calvin-college-team-pica/final-design-report/README.md

# final-design-report
Final Design Report for Senior Design project
