calvin-college-team-pica/final-design-report/tables/EMeter_Pinout.tex

{
\begin{longtable}[c]{|l|c|r|}
\caption{MSP430F47197 Pinout}\\
\hline
\rowcolor{lightgray}
  Pin Number & Pin Name & Pin Function\\ \hline\hline
\endfirsthead

\caption[]{Continued from previous page}\\
\hline
\rowcolor{lightgray}
  Pin Number & Pin Name & Pin Function\\ \hline\hline
\endhead

\multicolumn{3}{r}{{Continued on next page}} \\
\endfoot

\endlastfoot

  1 & A0+ & Phase 1 Voltage (Positive) \\
  2 & A0- & Phase 1 Voltage (Negative) \\
  3 & A1+ & Phase 2 Voltage (Positive) \\
  4 & A1- & Phase 2 Voltage (Negative) \\
  5 & A2+ & Phase 3 Voltage (Positive) \\
  6 & A2- & Phase 3 Voltage (Negative) \\
  7 & AVSS & Tie to Ground (GND) \\
  8 & AVCC & $3\volt$ input \\
  9 & VREF & Virtual Ground \\
  10 & A3+ & Phase 1 Current (Positive) \\ \hline
  11 & A3- & Phase 1 Current (Negative) \\
  12 & A4+ & Phase 2 Current (Positive) \\
  13 & A4- & Phase 2 Current (Negative) \\
  14 & A5+ & Phase 3 Current (Positive) \\
  15 & A5- & Phase 3 Current (Negative) \\
  16 & A6+ & Unused \\
  17 & A6- & Unused \\
  18 & VSS & Tie to Ground (GND) \\
  19 & S0 & LCD segment pin 00 \\
  20 & S1 & LCD segment pin 01 \\ \hline
  21 & S2 & LCD segment pin 02 \\
  22 & S3 & LCD segment pin 03 \\
  23 & S4 & LCD segment pin 04 \\
  24 & S5 & LCD segment pin 05 \\
  25 & S6 & LCD segment pin 06 \\
  26 & S7 & LCD segment pin 07 \\
  27 & S8 & LCD segment pin 08 \\
  28 & S9 & LCD segment pin 09 \\
  29 & S10 & LCD segment pin 10 \\
  30 & S11 & LCD segment pin 11 \\ \hline
  31 & S12 & LCD segment pin 12 \\
  32 & S13 & LCD segment pin 13 \\
  33 & S14 & LCD segment pin 14 \\
  34 & S15 & LCD segment pin 15 \\
  35 & S16 & LCD segment pin 16 \\
  36 & S17 & LCD segment pin 17 \\
  37 & S18 & LCD segment pin 18 \\
  38 & S19 & LCD segment pin 19 \\
  39 & S20 & LCD segment pin 20 \\
  40 & S21 & LCD segment pin 21 \\ \hline
  41 & S22 & LCD segment pin 22 \\
  42 & S23 & LCD segment pin 23 \\
  43 & S24 & LCD segment pin 24 \\
  44 & S25 & LCD segment pin 25 \\
  45 & S26 & LCD segment pin 26 \\
  46 & S27 & LCD segment pin 27 \\
  47 & S28 & LCD segment pin 28 \\
  48 & S29 & LCD segment pin 29 \\
  49 & S30 & LCD segment pin 30 \\
  50 & S31 & LCD segment pin 31 \\
  51 & S32 & LCD segment pin 32 \\
  52 & S33 & LCD segment pin 33 \\
  53 & S34 & LCD segment pin 34 \\
  54 & S35 & LCD segment pin 35 \\
  55 & P5.0 & Unused \\
  56 & COM0 & LCD commmon 0 \\
  57 & COM1 & LCD commmon 1 \\
  58 & COM2 & LCD commmon 2 \\
  59 & COM3 & LCD commmon 3 \\
  60 & P5.5 & Unused \\
  60 & P5.5 & Unused \\
  60 & P5.5 & Unused \\
  63 & LCDCAP & Charge pump capactior ($22\micro\farad$ to ground) \\
  64 & DVCC2 & Digital voltage input ($1.5\volt$) \\
  65 & XIN & $32.768\kilo\hertz$ crystal \\
  66 & XOUT & $32.768\kilo\hertz$ crystal \\
  67 & DVSS2 & Tie to Ground (GND) \\
  68 & S36 & LCD segment pin 36 \\
  69 & S37 & LCD segment pin 37 \\
  70 & S38 & LCD segment pin 38 \\
  71 & S39 & LCD segment pin 39 \\
  72 & P3.3 & Unused \\
  73 & P3.2 & Unused \\
  74 & P3.1 & Unused \\
  75 & P3.0 & Unused \\
  76 & P2.7 & Unused \\
  77 & P2.6 & Unused \\
  78 & P2.5 & RS232 RX \\
  79 & P2.4 & RS232 TX \\
  80 & P2.3 & Button \\
  81 & P2.2 & Unused \\
  82 & P2.1 & Unused \\
  82 & P2.0 & Unused \\
  82 & P1.7 & Unused \\
  85 & P1.6 & LED3 (Green)\\
  86 & P1.5 & LED2 (Amber)\\
  85 & P1.4 & LED1 (Red) \\
  88 & P1.3 & Unused \\
  89 & P1.2 & LCD Backlight LED \\
  90 & P1.1 & Unused \\
  91 & P1.0 & Unused \\
  92 & DVCC & $100\nano\farad$ capacitor \\
  93 & XT2OUT & $16.000\mega\hertz$ crystal \\
  94 & XT2IN & $16.000\mega\hertz$ crystal \\
  95 & DVSS1 & Tie to Ground (GND) \\
  96 & TDO/TDI & JTAG Test Data Out/In \\
  97 & TDI/TCLK & JTAG Test Data Out / Test Clock \\
  98 & TMS & Test Mode Select \\
  99 & TCK & Test Clock \\
  100 & RST & Reset (Assert Hi) \\ \hline
\end{longtable}
}
