calvin-college-team-pica/final-design-report/acronyms.tex

%\begin{table}[htdp]
%\caption{default}
\section{Acronyms}
\begin{acronym}[TDMA]
\acro{AC}{Alternating Current}
\acro{AD}{Analog Devices}
\acro{ADC}{Analog-to-Digital Converter}
\acro{AES}{Advanced Encryption Standard}
\acro{AMR}{Automated Meter Reading}
\acro{ANSI}{American National Standards Institute}
\acro{CAD}{Computer Aided Design}
\acro{CCS4}{Code Composer Studio 4}
\acro{CDMA}{Code Devision Multiple Access}
\acro{CF}{Compact Flash}
\acro{CPLD}{Complex Programmable Logic Device}
\acro{DC}{Direct Current}
\acro{DHCP}{Dynamic Host Configuration Protocol}
\acro{DIP}{Dual Inline Package}
\acro{DMM}{Digital Multi-Meter}
\acro{DOE}{United States Department of Energy}
\acro{DSR}{Data Set Ready}
\acro{DTR}{Data Transmit Ready}
\acro{EEPROM}{Electronically Erasable Programable Read Only Memory}
\acro{ESP}{Electronic Signal Processing}
\acro{EM}{electromagnetic}
\acro{FCC}{Federal Communications Commission}
\acro{FET}{Field-Effect Transistors}
\acro{FPGA}{Field Programable Gate Array}
\acro{FPU}{Floating Point Unit}
\acro{GCC}{\acs{GNU} Compiler Collection}
\acro{GNU}{GNU's not Unix}
\acro{GPL}{GNU General Public License}
\acro{HTTP}{Hypertext Transfer Protocol}
\acro{IC}{Integrated Circuit}
\acro{IEC}{International Electrotechnical Commision}
\acro{IEEE}{International Electrical and Electronics Engineers}
\acro{ISR}{Interrupt Service Routine}
\acro{JCI}{Johnson Controls, Inc.}
\acro{JTAG}{Joint Test Area Group}
\acro{LAN}{Local Area Network}
\acro{LCD}{Liquid Crystal Display}
\acro{LED}{Light Emitting Diode}
\acro{MCU}{Master Control Unit}
\acro{MSRP}{Manufacturer Suggested Retail Price}
\acro{NEMA}{National Electrical Manufacturers Association}
\acro{NIC}{Network Interface Card}
\acro{NILM}{Non-intrusive Load Monitoring}
\acro{NPC}{National Power Corporation}
\acro{NTP}{Network Time Protocol}
\acro{OS}{Operating System}
\acro{PICA}{Power Information Collection Architecture}
\acro{PC}{Personal Computer}
\acro{PCB}{Printed Circuit Board}
\acro{PPFS}{Project Proposal and Feasibility Study}
\acro{RAM}{Random-Access Memory}
\acro{RFID}{Radio Frequency Identification Device}
\acro{RMS}{Root Mean Square}
\acro{RS232}{Recommended Standard 232}
\acro{SD}{Secure Digital}
\acro{SI}{International System of Units}
\acro{SoC}{System on a Chip}
\acro{SPI}{Serial Peripheral Bus}
\acro{TI}{Texas Instruments}
\acro{TRST}{Test Reset}
\acro{UART}{Universal Asynchronous Receiver/Transmitter}
\acro{UL}{Underwriters Laboratories}
\acro{USB}{Universal Serial Bus}
\acro{VHDL}{\ac{VHSIC} Hardware Description Language}
\acro{VHSIC}{Very High Speed Integrated Circuit}
\end{acronym}
%\label{default}
%\end{table}%
