calvin-college-team-pica/final-design-report/bootstrap.tex

\documentclass[11pt,letterpaper]{article}

\usepackage[load-configurations=version-1]{siunitx}
\usepackage{graphicx}
\usepackage{longtable}
\usepackage{outlines}

\usepackage[margin=1in]{geometry}

\usepackage{hyperref}
\usepackage{hypcap}

\newcommand{\inch}{mathrm{in}}

\begin{document}
%  \include{individualMonitor}
\include{PowerSupply}
\end{document}
