calvin-college-team-pica/final-design-report/breaker_appendix.tex

%appendix something-or-other
%code for the arduino uno

\section{Smart Breaker Appendix}
\label{sec:breaker_appendix1}

\arduinocode{code/SPI_revI}{Software Code for Arduino Uno}
