calvin-college-team-pica/final-design-report/Business_Case.tex

\section{Business Case}
\input{business/industry_profile}
\input{business/business_strategy}
\input{business/competitor_analysis}
\input{ten_year_forecast}
