calvin-college-team-pica/final-design-report/PowerSupply_appendix.tex

\section{Power Supply Photographs}
%\addtocontents{toc}{\thispagestyle{fancyplain}}
\begin{figure}[htbp]
\begin{center}
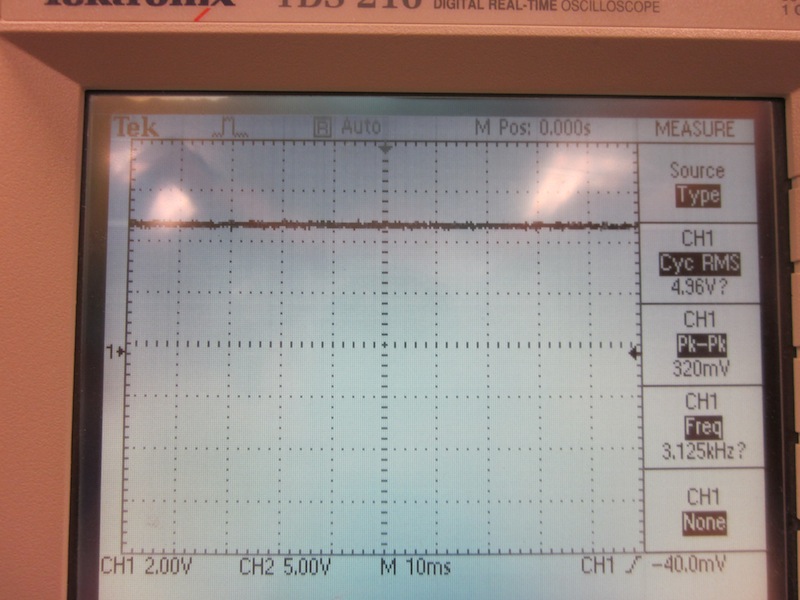
[picture p55: includes/IMG_0181.JPG]

\caption{Oscilloscope Reading-Shows about $4.96\volt$}
\end{center}
\end{figure}

\begin{figure}[htbp]
\begin{center}
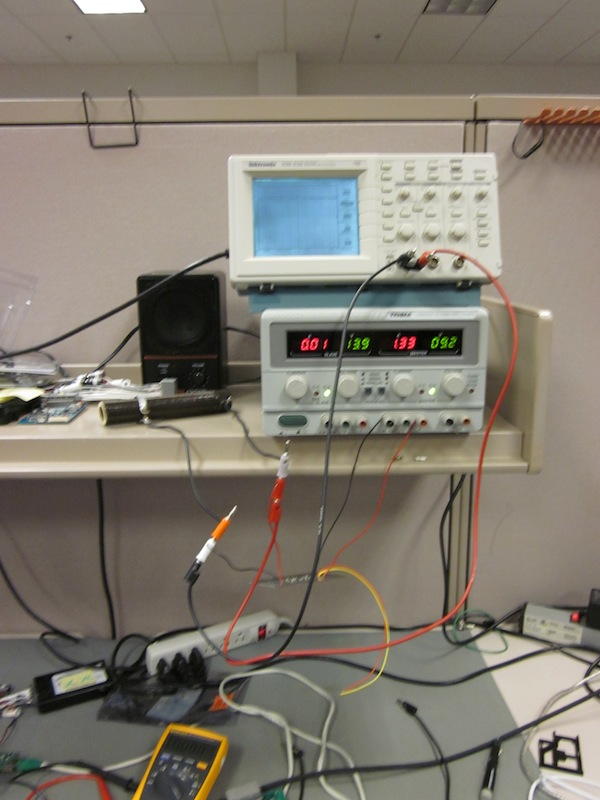
[picture p56: includes/IMG_0182.JPG]

\caption{General Test Setup}
\end{center}
\end{figure}

\begin{figure}[htbp]
\begin{center}
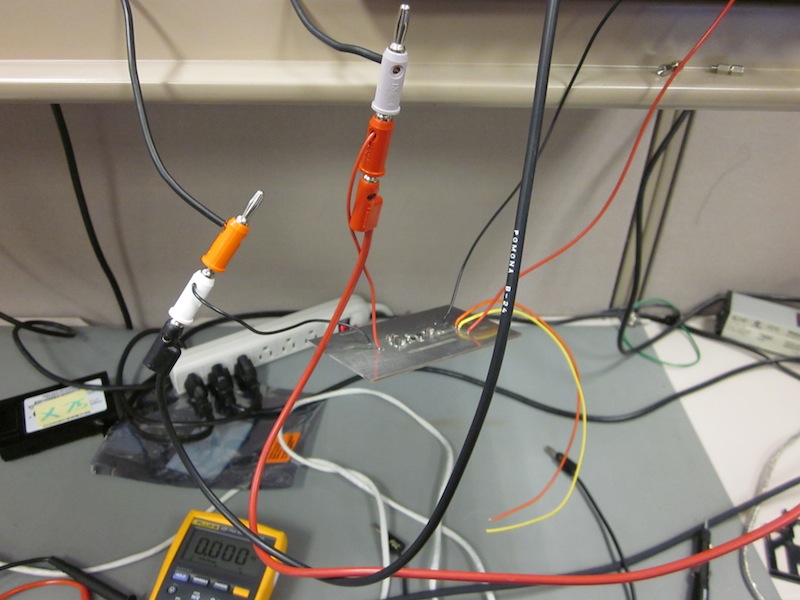
[picture p57: includes/IMG_0183.JPG]

\caption{Power Supply Being Tested}
\end{center}
\end{figure}

\begin{figure}[htbp]
\begin{center}
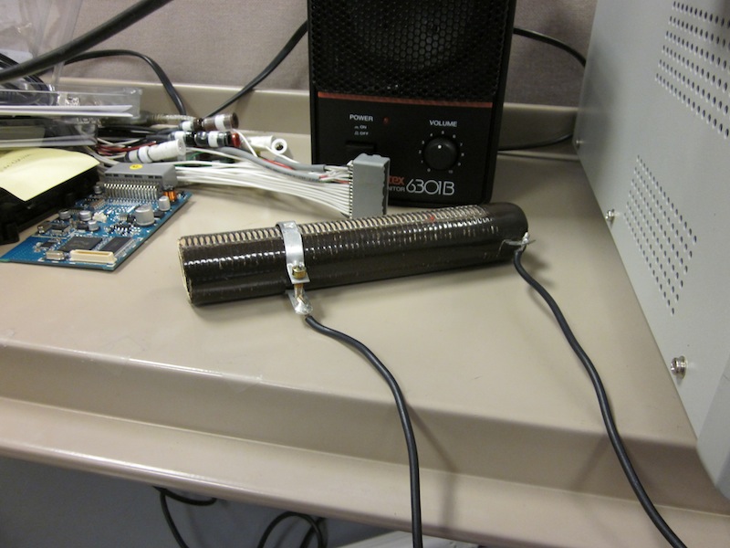
[picture p58: includes/IMG_0184.JPG]

\caption{$2.5\ohm$ Load}
\end{center}
\end{figure}
