calvin-college-team-pica/final-design-report/project_finances.tex

% \section{Project Finances}

% \subsection{Board Cost} 
% \begin{figure}[htbp]
%   \centering
%   \includegraphics[height=7in]{business/b_includes/Power_Supply_board_and_key}
%   \caption{Power supply board mockup, 92.5 x 95 mm.}
%   \label{fig:power_supply_board_mockup}
% \end{figure}
% \begin{figure}[htbp]
%   \centering
%   \subfloat[]{\label{fig:sb_board}\includegraphics[width=3in]{business/b_includes/smart_breaker_board}}\\
%   \subfloat[]{\label{fig:sb_key}\includegraphics[width=2in]{business/b_includes/smart_breaker_key}}
%   \caption{Smart breaker board mockup 72mm x 58.4mm.}
%   \label{fig:smart_breaker_board_mockup}
% \end{figure}
% \begin{figure}[htbp]
%   \centering
%   \subfloat[]{\includegraphics[height=6in]{business/b_includes/e_meter_board}}\\
%   \subfloat[]{\includegraphics[width=1in]{business/b_includes/e_meter_key}}
%   \caption{E-Meter board mockup 90mm x 47mm.}
%   \label{fig:e_meter_board_mockup}
% \end{figure}
