calvin-college-team-pica/final-design-report/business/b_tables/Power_Supply_Batch.tex

{
\begin{longtable}[c]{|>{\centering}b{1in}|c|c|c|>{\centering}b{1in}|c|}
\caption{Materials and Cost for 1000 Power Supplies\label{Power_Supply_Batch.tex}}\\
\hline
\rowcolor{blue}
Part & Quantity & Price per 1000 & For 1000 Systems & Manufacturer Part \# & Vendor \\
\hline
\endfirsthead
\caption[]{Continued from previous page}\\

\hline
\rowcolor{blue}
Part & Quantity & Price per 1000 & For 1000 Systems & Manufacturer Part \# & Vendor \\
\hline
\endhead
\multicolumn{6}{r}{{Continued on next page}} \\
\endfoot

\endlastfoot
1000uF Cap            & 1  & 2.02  & 2020     & TVX1J102MCD        & Mouser  \\
\hline
10u Cap               & 3  & 0.055 & 165      & C1206C106K9PACTU   & Mouser  \\
\hline
100n Cap              & 2  & 0.007 & 14       & C1608Y5V1H104Z     & Mouser  \\
\hline
47n Cap               & 1  & 0.036 & 36       & C1608X7S2A473K     & Mouser  \\
\hline
2.2n Cap              & 1  & 0.08  & 80       & 06035C222K4Z2A     & Mouser  \\
\hline
1n Cap                & 1  & 0.006 & 6        & C1608X7R1H102M     & Mouser  \\
\hline
2A 30V Schottky Diode & 1  & 0.169 & 169      & RB060M-30TR        & Mouser  \\
\hline
4.7u Inductor         & 1  & 0.34  & 340      & SRR0604-4R7ML      & Mouser  \\
\hline
56K Resistor          & 1  & 0.37  & 370      & RG1608N-563-B-T1   & Mouser  \\
\hline
15K Resistor          & 1  & 0.072 & 72       & TNPW060315K0DEEA   & Mouser  \\
\hline
10K Resistor          & 1  & 0.472 & 472      & PAT0603E1002BST1   & Mouser  \\
\hline
1.5K Resistor         & 2  & 0.47  & 940      & TNPW06031K50BEEN   & Mouser  \\
\hline
10 Resistor           & 2  & 0.37  & 740      & TNPW060310R0BEEA   & Mouser  \\
\hline
0.1 Resistor          & 1  & 0.121 & 121      & CRL1206-FW-R100ELF & Mouser  \\
\hline
LM25011               & 1  & 2.835 & 2835     & LM25011MY/NOPB     & Digikey \\
\hline
Transformer           & 1  & 17.28 & 17280    & 166M18             & Mouser  \\
\hline
Diode                 & 4  & 0.042 & 168      & 1N4004G            & Mouser  \\
\hline
Total:                & 25 &       & 25828.00 &                    &         \\
\hline
\hline
\end{longtable}
}
