calvin-college-team-pica/final-design-report/includes/Simplified_MSP430.pdf

Sensors | Microcontroller

LCD Display

Data Link

Debug Interface
