calvin-college-team-pica/final-design-report/business/b_includes/Power_Supply_Correct_Dims.pdf

Transformer

1000pF Cap

Diode for Bridge

LM25011

SMD Cap

Resistor

Diode
Inductor
