calvin-college-team-pica/final-design-report/includes/board_size/Breakers_Board_Est.pdf

Switch

SSR
Resistor

Opto Isolator
LED
Current
Transformer
ADE7763

Crystal

## Total=72mm X 58.4mm
