calvin-college-team-pica/final-design-report/includes/board_size/EMeter_Board_Est.pdf

Switch

Inductor
Resistor

Varistor
LED

MSP430

Diode

Crystal

Capacitor
Xbee
Max233
BJT

## Total= 90mm X 47mm

MOSFET
LCD
Display
