calvin-college-team-pica/final-design-report/includes/board_size/Power_Supply_Board_Est.pdf

Transformer

1000pF Cap

Diode for Bridge

LM25011

SMD Cap

Resistor

Diode
Inductor

# Total 95mm X 65mm
