calvin-college-team-pica/final-design-report/Final_Design_Report.tex

\documentclass[11pt,letterpaper,titlepage]{article}
% Change "article" to "report" to get rid of page number on title page
\usepackage{amsmath,amsfonts,amsthm,amssymb}
\usepackage[margin=1in]{geometry}
\usepackage{setspace}
\usepackage[T1]{fontenc}                                 %Provides T1 Font encoding for European characters
\usepackage{Tabbing}
\usepackage{array}                                       % Allows for making new column types
\usepackage{dcolumn}					 % Provides decimal alignment column macros
\usepackage{fancyhdr}                                    % Produce a "fancy" header using \rhead,\chead,\lhead
\usepackage{lastpage}
\usepackage{extramarks}
\usepackage{chngpage}
\usepackage{chngcntr} 				         % figure and equation numbering by section
\usepackage{soul}
\usepackage{bookmark}                                    % Prevents having to re-run due to labels
\usepackage[usenames,dvipsnames]{color}
\usepackage{graphicx,float,wrapfig}
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
   % passage

   \noindent\fbox{\begin{minipage}[c]{\columnwidth}#1\end{minipage}}%
   \enterProblemHeader{\homeworkProblemName}\exitProblemHeader{\homeworkProblemName}%
   \marginpar{\fbox{\homeworkSectionName}}%

   % We put the blank space above in order to make sure this
   % \marginpar gets correctly placed.
}%
   
\newcounter{subsubsubsection}[subsubsection]
\def\subsubsubsectionmark#1{}
\def\thesubsubsubsection {\thesubsubsection
     .\arabic{subsubsubsection}}
\def\subsubsubsection{\@startsection
     {subsubsubsection}{4}{\z@} {-3.25ex plus -1
     ex minus -.2ex}{1.5ex plus .2ex}{\normalsize\sf}}
% mj02r: original:
%\def\l@subsubsubsection{\@dottedtocline{4}
%     {4.8em}{4.2em}}
% mj02r: for VCE reports:
%\def\l@subsubsubsection{\@dottedtocline{4}
%     {7em}{3.8em}}
% mj02r, 29/12/2004: for thesis:
\def\l@subsubsubsection{\@dottedtocline{4}
     {11.1em}{4.6em}}

\makeatletter
\renewcommand{\paragraph}{\@startsection{paragraph}{4}{0ex}%
   {-3.25ex plus -1ex minus -0.2ex}%
   {1.5ex plus 0.2ex}%
   {\normalfont\normalsize\bfseries}}
\makeatother
   
% Includes a MATLAB script.
% The first parameter is the label, which also is the name of the script
%   without the .m.
% The second parameter is the optional caption.
\newcommand{\matlabscript}[2]
  {\begin{spacing}{1}\begin{itemize}\item[]\lstinputlisting[language=MATLAB,caption=#2,label=#1]{#1.m}\end{itemize}\end{spacing}}  
  
\newcommand{\ccode}[2]
  {\begin{spacing}{1}\begin{itemize}\item[]\lstinputlisting[language={C++},caption=#2,label=#1]{#1.c}\end{itemize}\end{spacing}}  
    
\newcommand{\assemblycode}[2]
  {\begin{itemize}\item[]\lstinputlisting[language={[x86masm]Assembler},caption=#2,label=#1]{#1.s}\end{itemize}}

\newcommand{\vhdlcode}[2]
  {\begin{itemize}\item[]\lstinputlisting[language={[AMS]VHDL},caption=#2,label=#1]{#1.vhd}\end{itemize}}

\newcommand{\perlcode}[2]
  {\begin{spacing}{1}\begin{itemize}\item[]\lstinputlisting[language={Perl},caption=#2,label=#1]{#1.pl}\end{itemize}\end{spacing}}

\newcommand{\arduinocode}[2]
  {\begin{spacing}{1}\begin{itemize}\item[]\lstinputlisting[language={C++},caption=#2,label=#1]{#1.pde}\end{itemize}\end{spacing}}
  
\newcommand{\degree}{$^{\circ}$}
\renewcommand{\textbeta}{$\beta\ $}
\def\tm{\leavevmode\hbox{$\rm {}^{TM}$}}

\newcommand{\inch}{\mathrm{in}}
%%%%%%%%%%%%%%%%%%%%%%%%%%%%%%%%%%%%%%%%%%%%%%%%%%%%%%%%%%%%%
%%%%%%%%%%%%%%%%%%%%%%%%%%%%%%%%%%%%%%%%%%%%%%%%
%This sets up the counters for the figures and equations to be numbered inside their sections
%\counterwithin{figure}{subsection}
%\counterwithin{equation}{section}
%\counterwithin{table}{subsection}
%\setcounter{secnumdepth}{5}
%\counterwithin{lst}{homeworkProblemCounter}
%%%%%%%%%%%%%%%%%%%%%%%%%%%%%%%%%%%%%%%%%%%%%%%%

%%%%%%%%%%%%%%%%%%%%%%%%%%%%%%%%%%%%%%%%%%%%%%%%%%%%%%%%%%%%%
% Make title
%\title{\vspace{2in}\textmd{\textbf{\hmwkAuthorName}}\\\normalsize\vspace{0.1in}\hmwkClass:\ \hmwkTitle \vspace{0.1in}\\Due\ on\ \hmwkDueDate\\\vspace{0.1in}\large{\textit{\hmwkClassInstructor\ \hmwkClassTime}}\vspace{3in}}
%\date{}
%\author{}
%\title{\vspace{2in}\textmd{\textbf{\hmwkClass:\ \hmwkTitle}}\\\normalsize\vspace{0.1in}\small{Due\ on\ \hmwkDueDate}\\\vspace{0.1in}\large{\textit{\hmwkClassInstructor\ \hmwkClassTime}}\vspace{3in}}
%\date{}
%\author{\textbf{\hmwkAuthorName}}

% IEEE Title
\title{Team PICA Final Design Report}
\date{\today}
\author{Amy Ball, Nate Jen, Avery Sterk, Kendrick Wiersma}

%%%%%%%%%%%%%%%%%%%%%%%%%%%%%%%%%%%%%%%%%%%%%%%%%%%%%%%%%%%%%
% PDF Metadata
\hypersetup{pdfinfo={
                     Title={Team 01: Final Design Report},
                     Subject={Engineering Design},
                     }}
%%%%%%%%%%%%%%%%%%%%%%%%%%%%%%%%%%%%%%%%%%%%%%%%%%%%%%%%%%%%%

\raggedright
\setcounter{tocdepth}{4}
\addtocontents{toc}{\protect\pagestyle{fancyplain}}
\addtocontents{lof}{\protect\pagestyle{fancyplain}}
\addtocontents{lot}{\protect\pagestyle{fancyplain}}
%\addtocontents{lol}{\protect\pagestyle{fancyplain}}

\begin{document}

%\maketitle % change this to a REAL titlepage
\begin{titlepage}
\begin{center}


{\LARGE \textbf{P}ower \textbf{I}nformation \textbf{C}ollection \textbf{A}rchitecture}

\vspace{0.5in}

{\LARGE Final Design Report}
\vspace{1in}

{\Large Engineering 340: Senior Design 2010-2011}

{\Large May 2011} % TODO: CHANGE THIS FOR FINAL

{\Large Team 01: Amy Ball, Nathan Jen, Avery Sterk, Kendrick Wiersma}
\vspace{0.25in}

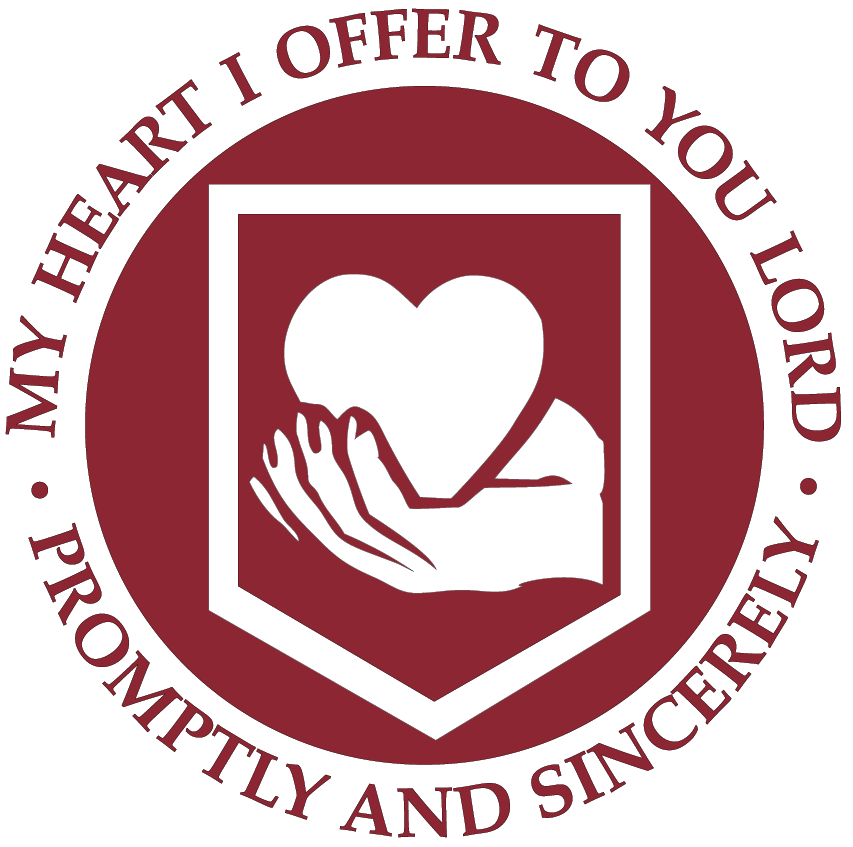
[picture p60: includes/CalvinLogo.png]


\vspace{0.25in}

{\Large Copyright 2011 Calvin College and Amy Ball, Nathan Jen, Avery Sterk, and Kendrick Wiersma}
\vspace{1in}

\end{center}
\end{titlepage}
\begin{abstract}
\input{abstract}
\end{abstract}
\newpage
\pagestyle{plain}
\tableofcontents
\newpage
%\thispagestyle{fancyplain}
\listoffigures
\listoftables
\lstlistoflistings
%\thispagestyle{fancyplain}

\newpage
\protect\pagestyle{mySuperFancy}
\begin{spacing}{1.5}
\setcounter{page}{1}
\include{acronyms}
\include{introduction}
\include{Scheduling}
\include{System_Overview}
\include{requirements}
\include{designGoals}
\include{E_Meter_Section}
\include{SSR_Section}
\include{CircuitIdentifier}
\include{Base_Station}
\include{PowerSupply}
\include{Business_Case}
\include{partsProjectCost}
\include{project_finances}
\include{acknowledgements}
\include{bibliography}
\appendix
\include{Scheduling_Appendix}
\include{E_Meter_Appendix}
\include{breaker_appendix}
\include{base_station_appendix}
\include{sparc_embedded_guide}
\include{PowerSupply_appendix}

\end{spacing}
\end{document}

%%%%%%%%%%%%%%%%%%%%%%%%%%%%%%%%%%%%%%%%%%%%%%%%%%%%%%%%%%%%%
