calvin-college-team-pica/final-design-report/business/b_tables/Breakers_Single.tex

{
\begin{longtable}[c]{|>{\centering}b{1in}|c|c|c|>{\centering}b{1in}|c|}
\caption{Materials and Cost for a Single Breaker\label{Breakers_Single.tex}}\\
\hline
\rowcolor{blue}
Item & Quantity & Unit Price & Single System & Manufacturer Part \# & Vendor \\
\hline
\endfirsthead
\caption[]{Continued from previous page}\\

\hline
\rowcolor{blue}
Item & Quantity & Unit Price & Single System & Manufacturer Part \# & Vendor \\
\hline
\endhead
\multicolumn{6}{r}{{Continued on next page}} \\
\endfoot

\endlastfoot
Solid State Relays  & 2 & 18.42 & 36.84 & STH24D25                  & Mouser \\
\hline
5pF SMD Cap         & 2 & 0.03  & 0.06  & C0603C0G1E050C            & Mouser \\
\hline
Opto Isolator       & 2 & 3.03  & 6.06  & OPI1264C                  & Mouser \\
\hline
3.579545MHz Crystal & 1 & 0.63  & 0.63  & ABLSG-3.579545MHZ-D-2-Y-T & Mouser \\
\hline
Total:              & 7 &       & 43.59 &                           &        \\
\hline
\hline
\end{longtable}
}
