calvin-college-team-pica/final-design-report/PowerSupply.tex.old.tex

\section{Power Supply}
\subsection{Requirements}
All requirements under this heading are to be assumed to be of the power supply (``the system'') unless explicitly stated otherwise.
\begin{outline}[enumerate]
\1 Shall be 78\% efficient.
\1 Shall power 2 ADE devices.
\1 Shall provide 5VDC +/- 5\%.
\1 Shall provide $2\milli\ampere$, $3\milli\ampere$ (total $5\milli\ampere$) plus a Safety factor.
\1 Shall also power an FPGA that will control these chips in a production-scale design at 5VDC $\pm5\%$.
\1 Shall also power the FPGA at $1.5\ampere$. 
\2 While the exact requirement for the FPGA are unknown the current was chosen much higher than probably needed in order to make sure the power supply would not need to be changed to provide more power.
\1 Shall have a ripple voltage of $~1\%$.
\1 Shall be isolated from mains supply by a high frequency transformer.
\1 Shall be small and not exceed $4\inch^3$.
\end{outline}
\subsection{Design Criteria}
\begin{outline}[enumerate]
\1 Size and weight: These could conflict however, if the size is no bigger than 4 cubic inches and all of the parts are surface mount, the heaviest part is the transformer. The power supply will not exceed 3 pounds.
\1 Output voltage: The output voltage will need to be sufficient for various loads. It will need to still remain at 5V
\1  Efficiency: This is very important. Linear power supplies are not very efficient, which is why the team decided to build a switched-mode power supply. They are generally 30\% more efficient than linear power supplies. 
\1 Heat: Shall not be hot enough to where heat sinks are required.
\1 Power Dissipation: Power dissipation shall be low.
\1 Complexity: Switched-mode power supplies are much more complex than linear. The complexity of the design should not get to the point where it would need explanation for an engineer in the field. 
\1 Electronic noise at input and outputs: The electronic noise at input and outputs shall not get to the point where compensation for noise is needed.
\end{outline}
\subsection{Alternatives}
\subsubsection{Buck converter}
 "The input voltage is converted into a lower output voltage."\cite{SMPSD}
\begin{figure}[h]
\begin{center}

\caption{Buck Converter}
\label{fig:1}
\end{center}
\end{figure}

\subsubsection{A boost converter} "The input voltage is converted into a higher output voltage"\cite{SMPSD}
\begin{figure}[H]
\begin{center}

\caption{Boost Converter}
\label{fig:1}
\end{center}
\end{figure}

\subsubsection{A buck-boost converter}
 "The input voltage is converted into a negative voltage"\cite{SMPSD}
\begin{figure}[H]
\begin{center}

\caption{Buck-Boost Converter}
\label{fig:1}
\end{center}
\end{figure}

\subsubsection{A flyback converter} 
"Several isolated output voltages, up to approximately 250 are possible"\cite{SMPSD}
\begin{figure}[H]
\begin{center}

\caption{Flyback Converter}
\label{fig:1}
\end{center}
\end{figure}

\subsubsection{Single Transistor Forward Converter} 
"One electrically isolated voltage, up to approximately 100 Watts."\cite{SMPSD}
\begin{figure}[H]
\begin{center}

\caption{Single Transistor Forward Converter}
\label{fig:1}
\end{center}
\end{figure}

\subsubsection{Two Transistor Forward Converter}
 "One electrically isolated voltage, up to approximately $1\kilo\watt$."\cite{SMPSD}
\begin{figure}[H]
\begin{center}

\caption{Two-Transistor Forward Converter}
\label{fig:1}
\end{center}
\end{figure}

\subsubsection{Half-Bridge Push-Pull Converter}
 "One electrically isolated voltage, up to few kilo watts."\cite{SMPSD}
\begin{figure}[H]
\begin{center}

\caption{Half-Bridge Push-Pull Converter}
\label{fig:1}
\end{center}
\end{figure}

\subsubsection{Full-Bridge Push-Pull Converter}
 "One electrically isolated voltage, up to many kilo watts."\cite{SMPSD}
\begin{figure}[H]
\begin{center}

\caption{Full-Bridge Push-Pull Converter}
\label{fig:1}
\end{center}
\end{figure}

%Source: \url{http://schmidt-walter.eit.h-da.de/smps\_e/smps\_e.html}

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

\subsection{Implementation}
\subsubsection{Scope}
This document describes the analysis of the $5\volt/2\ampere$, LM25011-Buck Converter.
\subsubsection{Module Overview and Block Diagram}
\begin{figure}[H]
\begin{center}

\caption{Buck Conversion Block Diagram}
\label{fig:1}
\end{center}
\end{figure}

\clearpage
\subsubsection{Schematics}
\begin{figure}[htbp]
\begin{center}
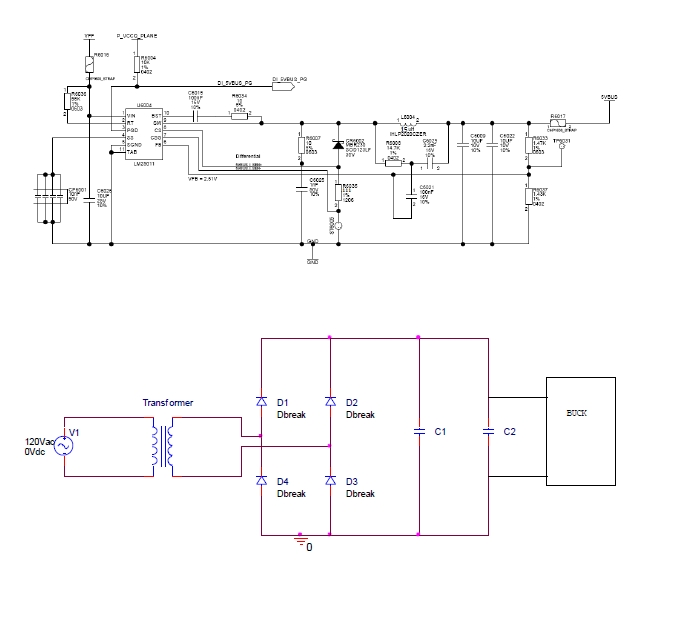
[picture p61: includes/Schematics.jpg]

\caption{Schematic of Power Supply as Buck Converter}
\label{fig:1}
\end{center}
\end{figure}

\subsubsection{Calculations}
This power supply will require a transformer and four diodes as shown in the schematics. These equations are for that part of the schematic.

\begin{equation}
V_{AC}=18 \volt
\end{equation}
 This is the voltage the transformer will output from a 120 $V_{AC}$ outlet.
\begin{equation}
Transformer_{peak}=VAC\sqrt{2}
\end{equation}
 Calculating for the rectifier circuit. This comes from the equation for finding $V_{rms}$, which is 
\begin{equation}
V_{rms}=\frac{V_p}{\sqrt{2}}
\end{equation}
$Current=2$ This is the desired output current.
\begin{equation}
dt=\frac{1}{120}
\end{equation} 
is the duration between charging cycles and is equal to 
\begin{equation}
\frac{1}{2*Main \ \ Frequency}
\end{equation}
 Therefore since in America the main frequency is 60Hz, 
\begin{equation}
dt=\frac{1}{120}
\end{equation}
\begin{eqnarray}
Overhead&=&1.4\\
dv=Transformer_{peak}-Overhead-8&=&16.056
\end{eqnarray}

We need this $8\volt$ for the switching regulator, it needs $3\volt$ of headroom and since we want $5\volt$ out we take the voltage $+3\volt$ and get $8\volt$, but for a little bit of watermark.
\typeout{WHY DO WE HAVE A WATERMARK ON A VOLTAGE???? at \the\inputlineno\space in PowerSupply.tex}

\begin{equation}
Capacitor=Current\frac{dt}{dv}
\end{equation}
\begin{equation}
Capacitor=.001\farad
\end{equation}
 This simply means that the capacitor(s) for filtering need to be at least $1\milli\farad$.

\textbf{Note:This is a minimum value} This value could be achieved by one capacitor or multiple as long as the total capacitance is at least $1\milli\farad$.

The diodes were selected based on the fact that Chuck Howerda gave them to our team and said they would work well for this application and for the diode bridge.

\input{PSCapabilityTable} 

\subsubsection{Theory of Operation}
"The LM25011 Constant On-time Step-Down switching regulator is capable of supplying up to $2\ampere$ of load current. This high voltage regulator contains an N-Channel Buck switch, a startup regulator, current limit detection,and internal ripple control. The constant on-time regulation principle requires no loop compensation, results in fast load transient response, and simplifies circuit implementation.

The operating frequency remains relatively constant with line and load. The adjustable valley current limit detection results in a smooth transition from constant voltage to constant current mode, when current limit is reached, without the use of current limit foldback. The PGD output indicates the output voltage has increased to within $5\percent$ of the expected regulation value.

Additional features include: Low output ripple, VIN under-voltage lock-out, adjustable soft-start timing, thermal shutdown, gate drive pre-charge, gate drive under-voltage lock-out, and maximum duty cycle limit."\cite{LM25011}
%Source: \url{http://www.national.com/pf/LM/LM25011.html\#Overview}
\subsubsection{Design Assumptions}
 VFF value is considered as min. $7.09\volt$ and max. $17.10\volt$ from Current draw of the chip in use.
\subsubsection{Analysis}
\begin{outline}[enumerate]
\1 Input voltage range:
\begin{equation}
P_{VFF}=7.09, 12.3, 17.1 \volt
\end{equation}
\2 Input Voltage range for the LM25011 is $6\volt$ to $42\volt$ 12.3V was choosen for a medium between 7.09 and 17.1.
\1 Output Voltage
\begin{equation}
P_{5V}=4.75, 5, 5.25 \volt
\end{equation}
\2 These values are from the 5\percent tolerance. 
\1 Load Current
\begin{equation}
I_{out}=2\ampere
\end{equation}
\2 Note: As per datasheet, LM25011 can deliver up to 2\ampere load current
\end{outline}

\subsubsection{Output Voltage Calculation}
Calculations from datasheet:
\begin{figure}[htbp]
\begin{center}

\caption{Calculation from datasheet}
\label{fig:1}
\end{center}
\end{figure}

\subsubsection{Selection of Switching Frequency}
Information from datasheet:

The maximum allowed frequency may be limited by the minimum and maximum input voltage, as described below:
\begin{outline}[enumerate]
\1 Operation at a low input voltage requires a high duty cycle to maintain output regulation. The maximum duty cycle is limited by the minimum off-time of the LM25011 (150ns typ., 208 ns max).  The output voltage drops out of regulation at low VIN if  the switching frequency does not satisfy the following condition:
\begin{equation}
Fsw < (Vin(min)-Vout) / ( Vin(min) x 208ns)
\end{equation}
\1 Operation at high input voltage requires a low duty cycle, limited by the minimum on-time of the LM25011 (90 ns). The switching frequency must satisfy the following condition to ensure the on-time is greater than 90 ns:
\begin{equation}
Fsw < Vout / (Vin(max) x 90ns)
\end{equation}
\end{outline}

If the selected value of Fsw does not satisfy this condition, the LM25011 maintains regulation, but the switching frequency will be lower than the desired value.

\begin{figure}[htbp]
\begin{center}

\caption{Condition from datasheet}
\label{fig:1}
\end{center}
\end{figure}

From the conditions shown, maximum switching frequency should not exceed $1.356 \mega\hertz$.

The approximate operating frequency is calculated as follows:
\begin{equation}
RT_{used}=\left( \begin{array}{ccc}
1-1\percent \\ 1 \\ 1+1\percent \\
\end{array} \right)
\end{equation}
\begin{equation}
V_in=P_{VFF}
\end{equation}

\begin{equation}
f_s=\frac{V_{out->nominal}}{(V_{in}15ns)+[4.1*10^{-11}(RT_{used}+.5\kilo\ohm)\ampere\second]}
\end{equation}
\begin{equation}
f_s=\left( \begin{array}{ccc}
2.121 \\ 2.035 \\ 1.961 \\ 
\end{array} \right)
\end{equation}
\begin{equation}
f_{sMAX}=2\mega\hertz \quad \hbox{From Datasheet}
\end{equation}

For the selected RT value, switching frequency is higher than 2MHz. However after speaking with the contact from National Semiconductor I have confirmed that LM25011 can operate up to 2.4MHz.

\subsubsection{Selection of Inductor}
As per JCI recommendations as well as National Semiconductor, we opted to use a 15\micro\henry inductor since they said it is the best to use because we will want more than the minimum requirement. 

\subsubsection{Ripple Current}
\begin{outline}[enumerate]
\1 Maximum Ripple Current
\begin{equation}
I_{ripple\_max}=(max(V_{in})-min(V_{out}))(\frac{min(T_{on\_min})}{min(L{recom})})
\end{equation}
\2 Note: This is acceptable.
\begin{equation}
I_{ripple\_max}=294.851\milli\ampere
\end{equation}
\1 Nominal Ripple Current
\begin{eqnarray}
I_{ripple\_nom}&=&(V_{in_1}-V_{out})(\frac{min(T_{on\_min})}{min(L{recom})})\\
I_{ripple\_nom}&=&175.525\milli\ampere
\end{eqnarray}
\1 Minimum Ripple Current
\begin{eqnarray}
I_{ripple\_min}&=&(min(V_{in})-max(V_{out}))(\frac{min(T_{on\_min})}{min(L{recom})})\\
I_{ripple\_min}&=&95.321\milli\ampere
\end{eqnarray}
\1 Inductor Peak Current
\begin{eqnarray}
I_{peak}&=&I_{out\_max}+\frac{I_{ripple\_max}}{2}\\
I_{peak}&=&2.147\ampere
\end{eqnarray}
\end{outline}

\subsubsection{Minimum Valley Threshold for Current Limit}
\begin{equation}
I_{valley\_th}=I_{out\_max}-\frac{I_{ripple\_min}}{2}
\end{equation}

\subsubsection{Current Sense Resistor}
As long as we have a current sense resistor that does not exceed $RS_{max}$ (located in the datasheet) it will be okay. The more current we want in our power supply the smaller our current sense resistor will need to be. Which we can vary as we see fit. The proportion to which this varies depends on the ripple voltage and the calculation for which is shown below.

\subsubsection{Ripple Voltage}
\begin{eqnarray}
RS_{ripple\_min}&=&min(RS_{used})min(I_{ripple\_min})\\
RS_{ripple\_min}&=&10.381 \milli\volt
\end{eqnarray}
As per datasheet, minimum ripple voltage across current sense resistor should be greater than $10\milli\volt$. In this case it is very close, but that should not be a problem.

\subsubsection{Power Dissipation}
We set the current sense resistor to get 1.5A out. Also, by the results of the testing we get 1.3A out instead of 1.5A. We still get 5V out. Therefore we can calculate the efficiency.
\begin{eqnarray}
Eff&=&\frac{P_{out}}{P_{in}}\\
Eff&=&\frac{1.3 \times 5}{1.5 \times 5}\\
Eff&=&88.7\% +/- 5\%
\end{eqnarray}

So, therefore $Eff=84.23\percent,\ \ 88.7\percent,\ \ 93.1\percent$

\subsubsection{Efficiency}
No adequate information is provided in the datasheet about power loss in LM25011, However to identify approximate power loss in LM25011, the \textbf{Efficiency of the LM25011 buck converter is simulated using National Semiconductor Webench tool for the same specification.}\cite{WEBENCH}

\begin{figure}[htbp]
\begin{center}

\caption{Circuit as shown in Webench}
\label{fig:1}
\end{center}
\end{figure}

\begin{figure}[htbp]
\begin{center}

\caption{LM25011 Efficiency graph from Webench tool $Eff=86.85\percent$}
\label{fig:1}
\end{center}
\end{figure}

\subsubsection{Total Output Power}
\begin{eqnarray}
P_{out}&=&max(V_{out})I_{out\_max}\\
P_{out}&=&10.383\watt\\
P_{in}&=&\frac{P_{out}}{Eff}\\
P_{in}&=&11.955\watt
\end{eqnarray}

\subsubsection{Approximate power loss in LM25011}
\begin{eqnarray}
PD_{LM25011}&=&P_{in}-PD_{ext}-P_{out}\\
PD_{LM25011}&=&223.948\milli\watt
\end{eqnarray}

\subsection{Testing}
First I tested just the power supply with no load to make sure it gave a $5\volt$ output, which was measured with a DMM. That was a success! After which, I put a load of $2.5\ohm$ to see how much current went through. Those values and test setup are shown in the pictures as follows:
\begin{figure}[htbp]
\begin{center}
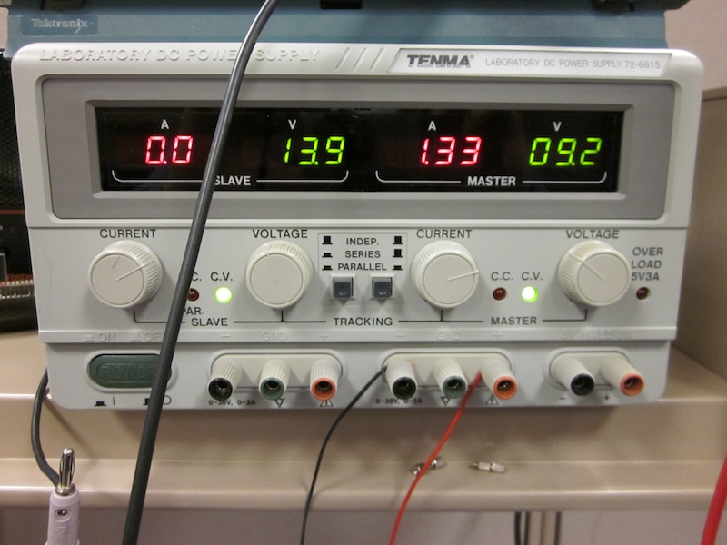
[picture p62: includes/IMG_0180.JPG]

\caption{Current and Input Voltage Reading}
\label{fig:1}
\end{center}
\end{figure}

%%%%%%%%%%%%%%%%%%%%%%%%%%%%%%%%%%%%%%%%%%%%%%%%%%%%%%%%%%%%%
