calvin-college-team-pica/final-design-report/Figures/NJADEread.jpg

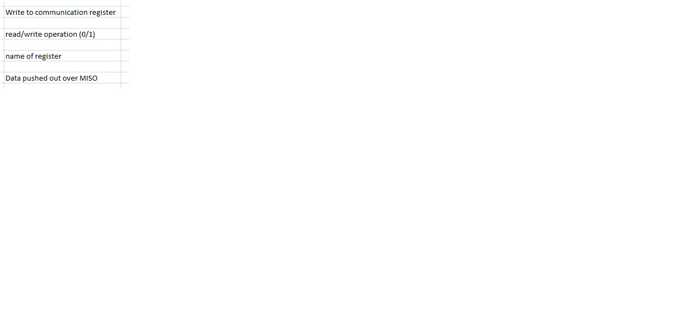
Figures/NJADEread.jpg
