calvin-college-team-pica/final-design-report/Figures/NJArduinoSoftware.jpg

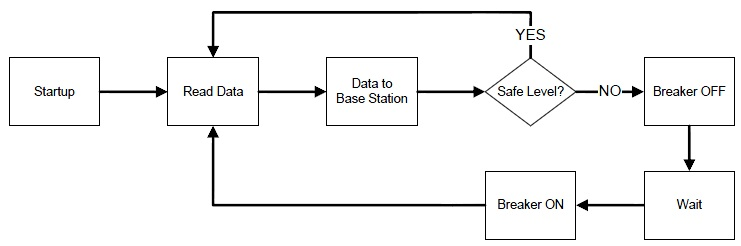
Figures/NJArduinoSoftware.jpg
