calvin-college-team-pica/final-design-report/Figures/NJArduinoSoftwareFlow.jpg

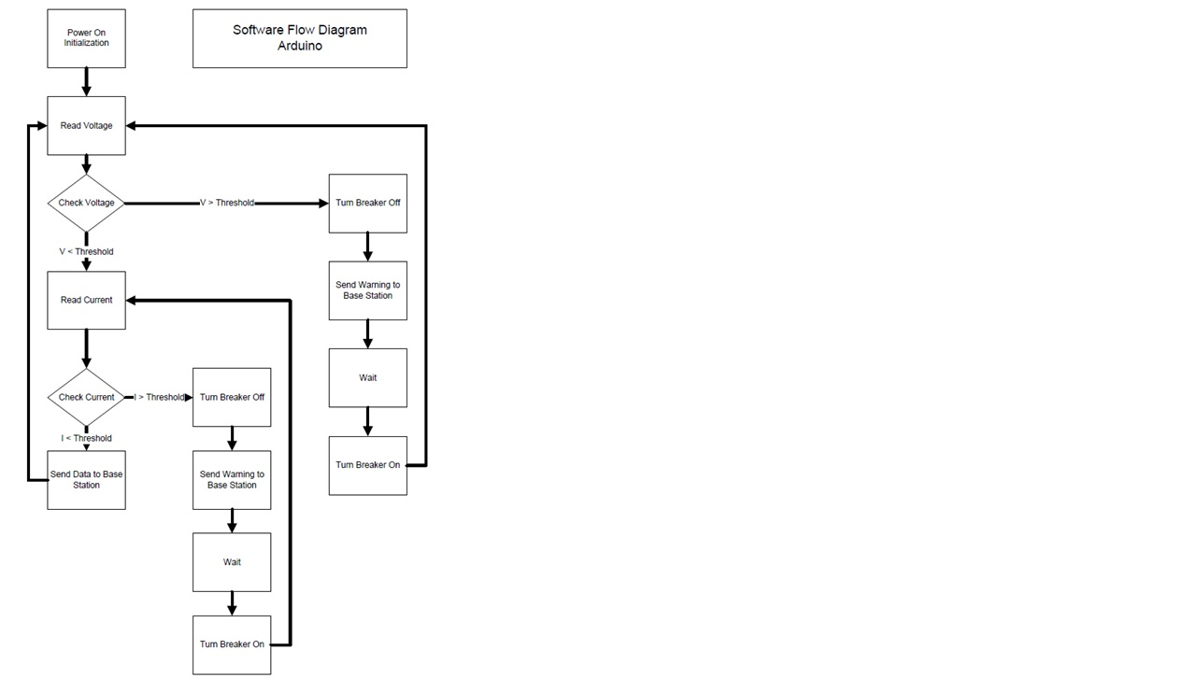
Figures/NJArduinoSoftwareFlow.jpg
