calvin-college-team-pica/final-design-report/Figures/NJAttenuationNetwork.jpg

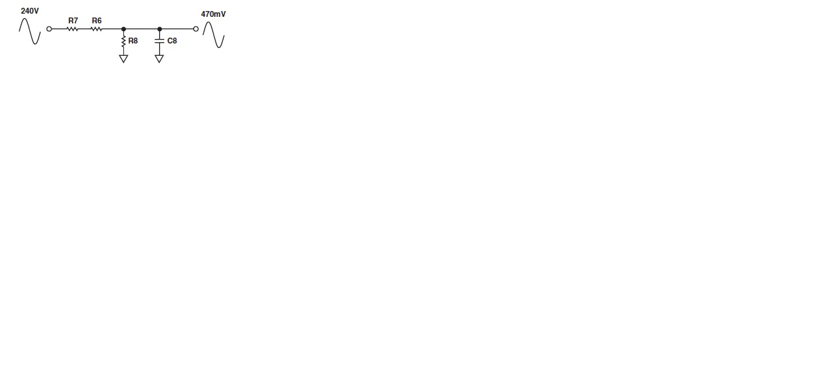
Figures/NJAttenuationNetwork.jpg
