calvin-college-team-pica/final-design-report/Figures/NJBreakerBlock.jpg

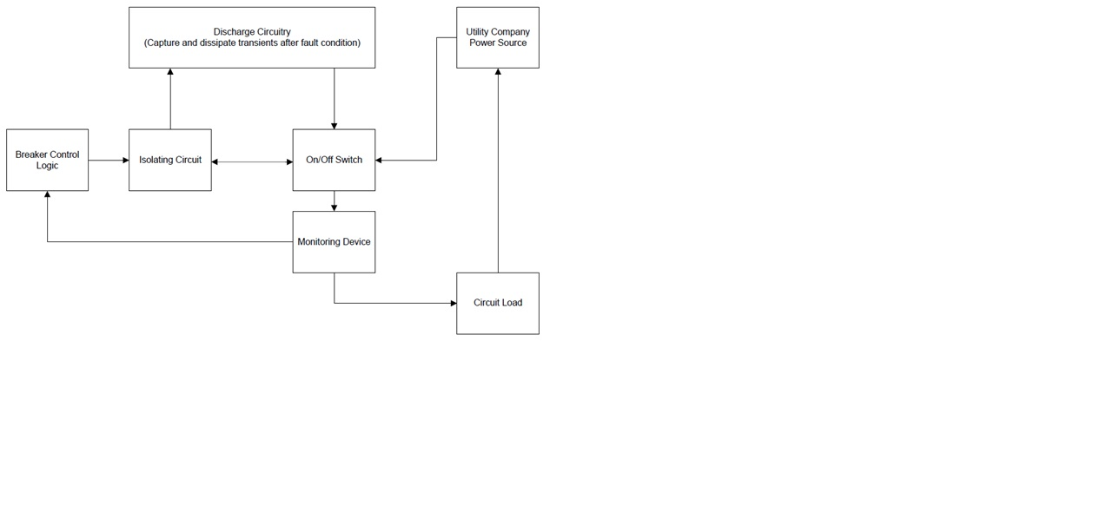
Figures/NJBreakerBlock.jpg
