calvin-college-team-pica/final-design-report/Figures/NJMonitorSystemDiagram.jpg

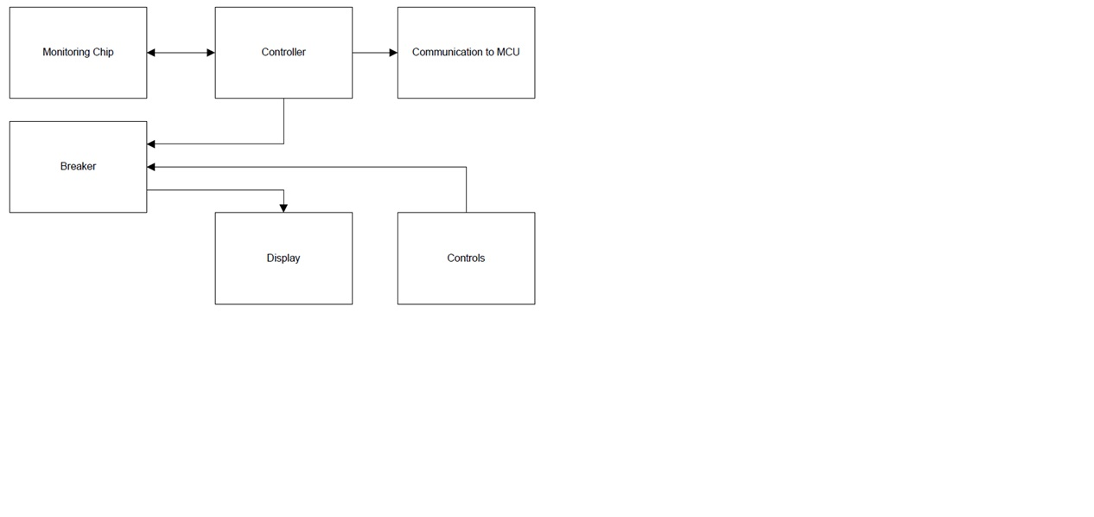
Figures/NJMonitorSystemDiagram.jpg
