calvin-college-team-pica/final-design-report/Figures/NJVoltDivOutput.jpg

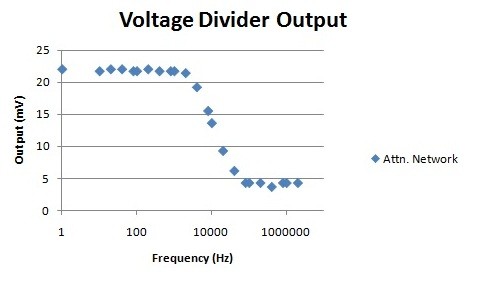
Figures/NJVoltDivOutput.jpg
