calvin-college-team-pica/final-design-report/includes/Buck.jpg

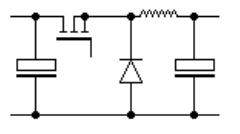
includes/Buck.jpg
