calvin-college-team-pica/final-design-report/includes/LEON3_Prototype_Block_Diagram.png

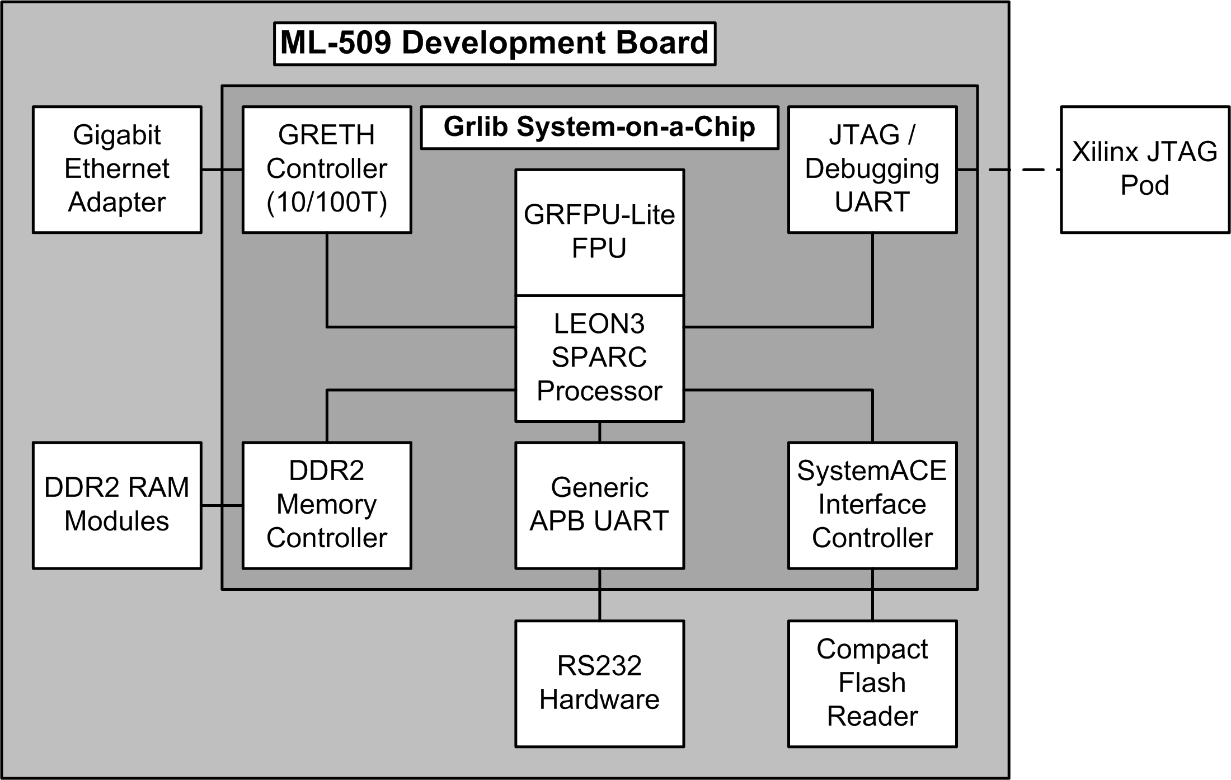
includes/LEON3_Prototype_Block_Diagram.png
