calvin-college-team-pica/final-design-report/includes/LTSpiceSchematic.jpg

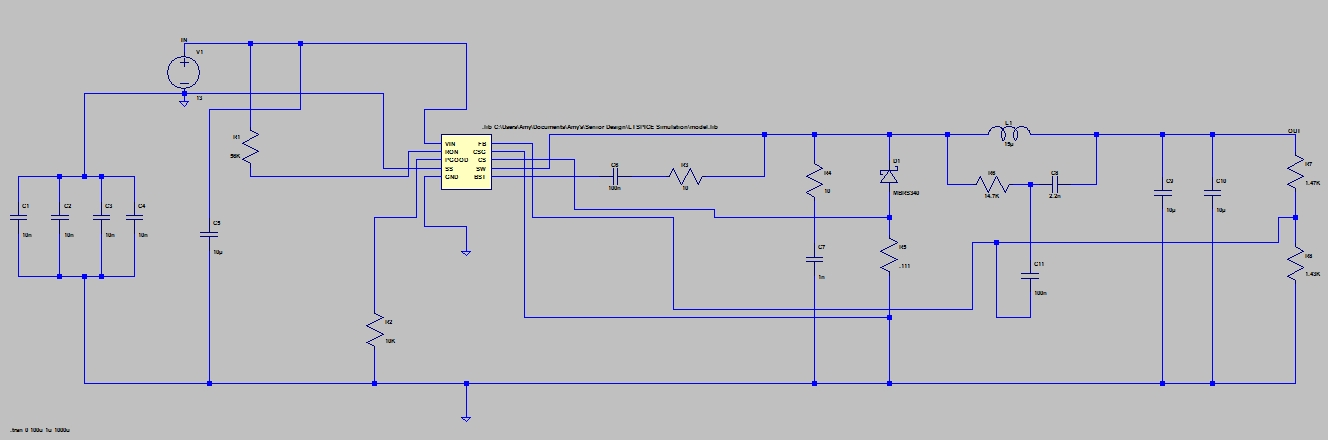
includes/LTSpiceSchematic.jpg
