calvin-college-team-pica/final-design-report/includes/PICA_System_Diagram.png

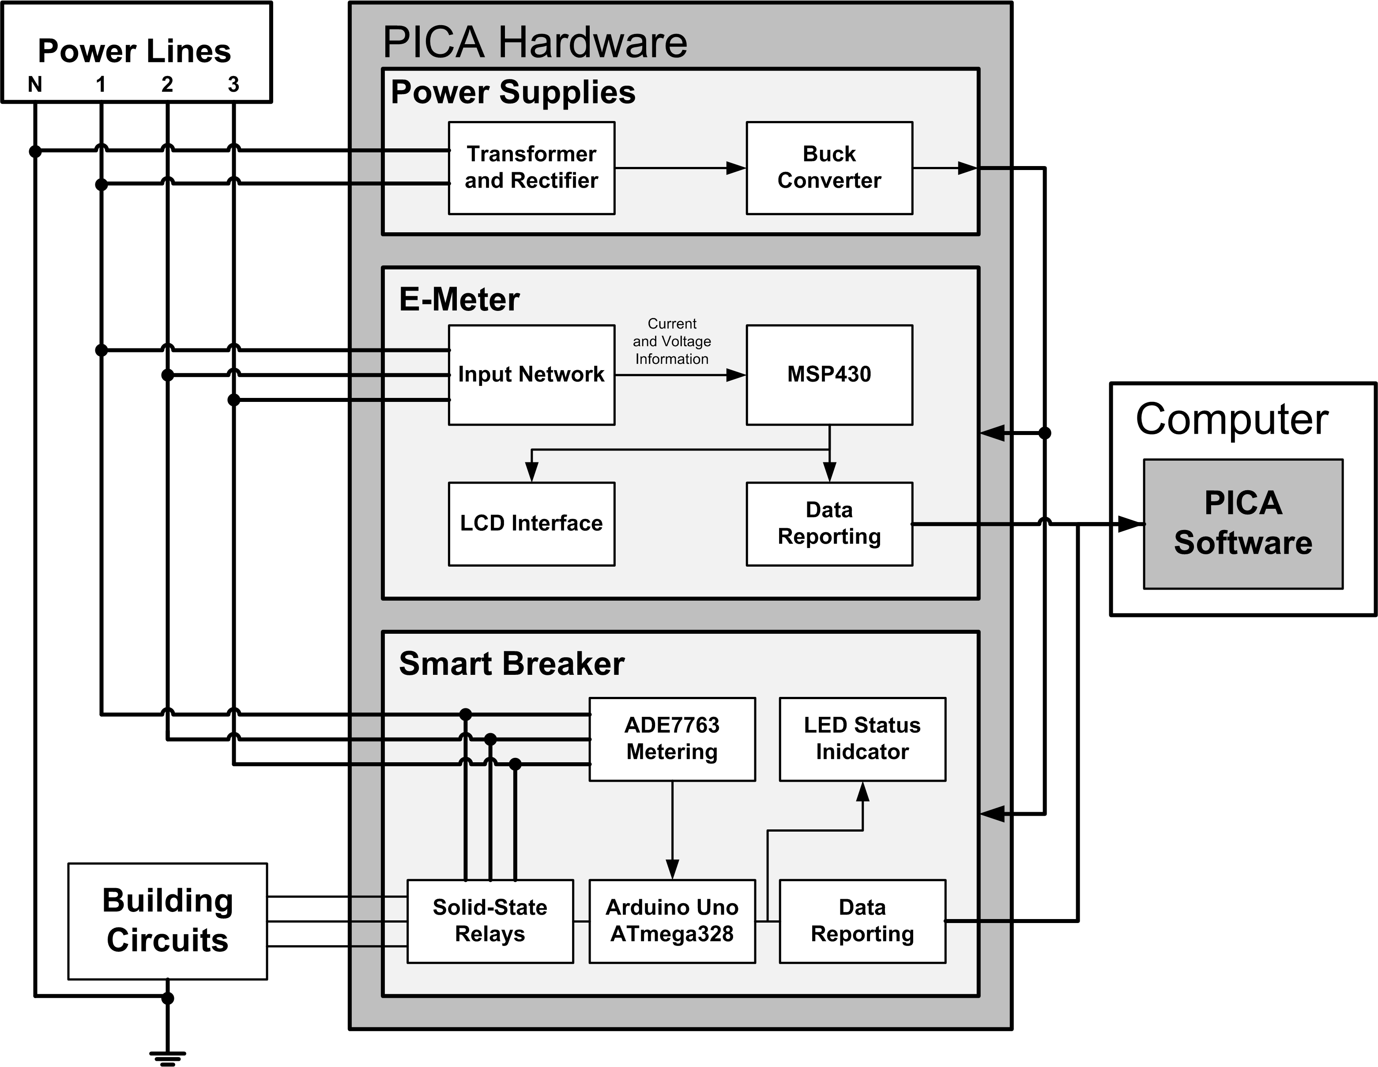
includes/PICA_System_Diagram.png
