calvin-college-team-pica/final-design-report/includes/power.jpg

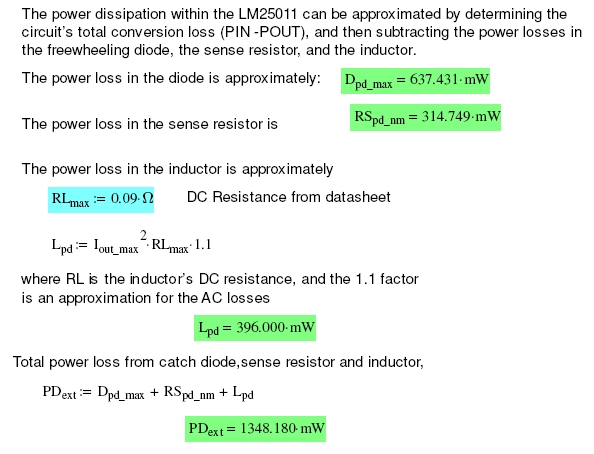
includes/power.jpg
