calvin-college-team-pica/final-design-report/includes/Scheduling_Screenshot.png

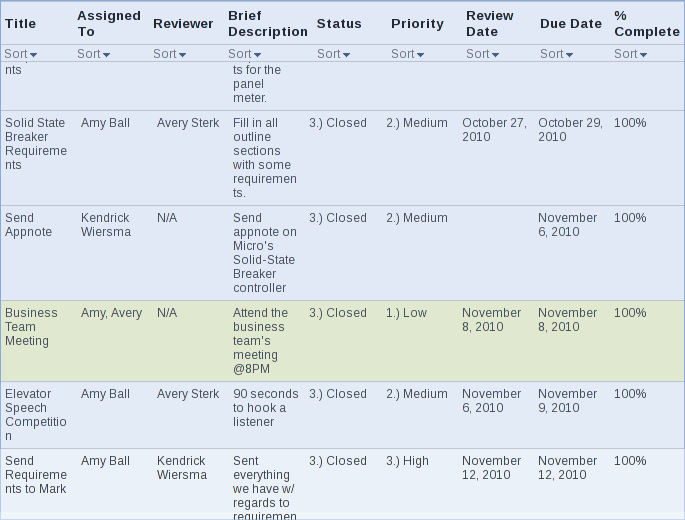
includes/Scheduling_Screenshot.png
