calvin-college-team-pica/final-design-report/includes/SD16_Current_Sense_Input.png

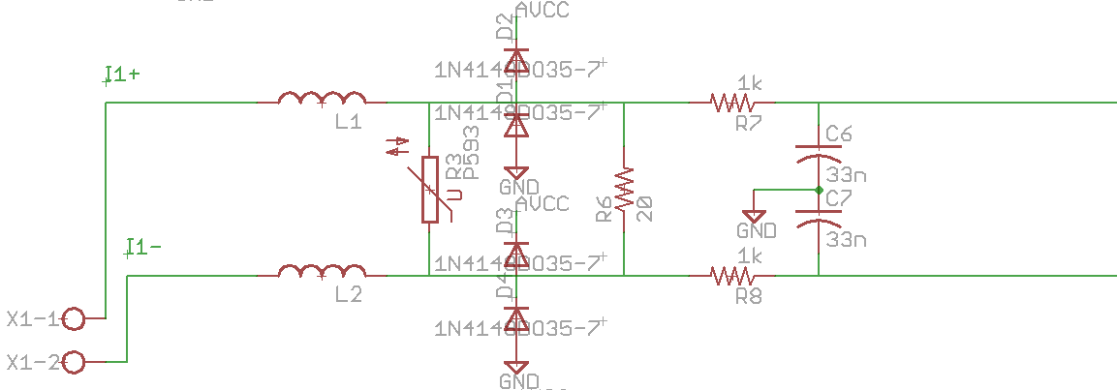
includes/SD16_Current_Sense_Input.png
