calvin-college-team-pica/final-design-report/BoM/Bill of Materials.xlsx

Sheet: Power Supply
Bill of Materials
Power Supply
 |  | Dimensions
Part | Package Size | Length | Width | Height | Unit Price | Price if ordering 1000 | Total for 1000 | Manufacturer Part # | Mouser or Digikey | Quantity | Total Price for 1 PS | Total Price for 1000 | Location on Schematic
10u Cap | 1206 | 3.2mm | 1.6mm | 1.5mm | $0.30 | $0.06 | $55.00 | C1206C106K9PACTU | M | 3 | $0.90 | $165.00 | C1, C7, C8
47n Cap | 603 | 1.6mm | 0.8mm | 0.8mm | $0.20 | $0.04 | $36.00 | C1608X7S2A473K | M | 1 | $0.20 | $36.00 | C2
100n Cap | 603 | 1.6mm | 0.8mm | 0.8mm | $0.03 | $0.01 | $7.00 | C1608Y5V1H104Z | M | 2 | $0.06 | $14.00 | C3, C6
1n Cap | 603 | 1.6mm | 0.8mm | 0.8mm | $0.03 | $0.01 | $6.00 | C1608X7R1H102M | M | 1 | $0.03 | $6.00 | C4
2.2n Cap | 603 | 1.6mm | 0.81mm | 0.9mm | $0.16 | $0.08 | $80.00 | 06035C222K4Z2A | M | 1 | $0.16 | $80.00 | C5
2A 30V Schottky Diode | SOD-123LF | 1.2mm | 0.85mm | 3.05mm | $0.55 | $0.17 | $169.00 | RB060M-30TR | M | 1 | $0.55 | $169.00 | D1
4.7u Inductor | IHPL-2020 | 6.5mm | 6.5mm | 4.8mm | $0.72 | $0.34 | $340.00 | SRR0604-4R7ML | M | 1 | $0.72 | $340.00 | L1
10K Resistor | 603 | .064mm | 0.032mm | .015mm | $1.10 | $0.47 | $472.00 | PAT0603E1002BST1 | M | 1 | $1.10 | $472.00 | R1
56K Resistor | 603 | 1.6mm | 0.8mm | 0.4mm | $1.60 | $0.37 | $370.00 | RG1608N-563-B-T1 | M | 1 | $1.60 | $370.00 | R2
10 Resistor | 603 | 1.6mm | 0.85mm | 0.45mm | $0.62 | $0.37 | $370.00 | TNPW060310R0BEEA | M | 2 | $1.24 | $740.00 | R3, R4
0.1 Resistor |  | 3.2mm | 1.6mm | 0.6mm | $0.30 | $0.12 | $121.00 | CRL1206-FW-R100ELF | M | 1 | $0.30 | $121.00 | R5
15K Resistor | 603 | 1.6mm | 0.85mm | 0.45mm | $0.10 | $0.07 | $72.00 | TNPW060315K0DEEA | M | 1 | $0.10 | $72.00 | R6
1.5K Resistor | 603 | 1.6mm | 0.85mm | 0.45mm | $0.79 | $0.47 | $470.00 | TNPW06031K50BEEN | M | 2 | $1.58 | $940.00 | R7, R8
LM25011 | MSSOP-EP 10 pin | 4.9mm | 2mm | .86mm | $4.86 | $2.83 | $2835.00 | LM25011MY/NOPB (http://search.digikey.com/scripts/DkSearch/dksus.dll?Detail&itemSeq=99203825&uq=634389932384553735) | D | 1 | $4.86 | $2835.00 | LM25011 (U1)
Transistor |  | 93.7 mm | 47.8 mm | 58.7 mm | $23.56 | $17.28 | $17280.00 | 166M18 (http://www.mouser.com/Search/ProductDetail.aspx?R=166M18virtualkey54600000virtualkey546-166M18) | M | 1 | $23.56 | $17280.00
Diode for rectifier bridge |  | 54.5mm | 2.5mm | 1.27mm | $0.23 | $0.04 | $42.00 | 1N4004G | M | 4 | $0.92 | $168.00
1000pF Filter Cap |  | 31.5mm | 16mm | 16mm | $3.18 | $2.02 | $2020.00 | TVX1J102MCD | M | 1 | $3.18 | $2020.00
Total | For 1: | $41.06 | For 1000: | $25828.00

Sheet: E-Meter
E-Meter
 |  | Dimensions
Item | Vendor | Length | Width | Height | Unit Price | Price if ordering 1000 | Total for 1000 | Item Number | Quantity | Total Price for 1 Meter | Total for 1000 | Location on Schematic
LCD Display | SynchroSystems |  |  |  | $22.75 | $14.00 | $14000.00 | SCLBC | 1 | $22.75 | $14000.00 | U2 | **Log scale for tredline
Break Away Headers -- Straight | SparkFun |  |  |  | $2.50 | $2.00 | $2000.00 | PRT-00116 | 1 | $2.50 | $2000.00
LCD Graphic Display Modules & Accessories | Mouser | 4mm | 49.2mm | 47.6mm | $18.55 | $14.00 | $14000.00 | NHD-C160100DiZ-FSW-FBW | 1 | $18.55 | $14000.00 |  | **Exponential trendline, but not being used in final design
FFC / FPC Connectors | Mouser |  |  |  | $1.29 | $0.47 | $467.00 | 52892-1495 | 2 | $2.58 | $934.00 | NA | ** Not being used in final design
Headers & Wire Housings | Mouser |  |  |  | $1.03 | $0.39 | $386.00 | 501568-0207 | 2 | $2.06 | $772.00 | NA | ** Not being used in final design
1N4148 Diode | Mouser | 25.40mm | 4mm | 4mm | $0.09 | $0.01 | $12.00 | 1N4148 | 24 | $2.16 | $288.00 | Input Board: D1-D12
2500 Series Box Header | Mouser |  |  |  | $1.41 | $0.88 | $880.00 | N2514-6002RB | 2 | $2.82 | $1760.00
AVE Series Electrolytic Cap 1uF | Mouser | 5.3mm | 4mm | 4.3mm | $0.07 | $0.04 | $36.00 | AVE105M50B12T-F | 12 | $0.84 | $432.00 | Main: C25
Kehmet .033uF SMD Cap | Mouser | 3.2mm | 1.6mm | 1.5mm | $0.59 | $0.24 | $240.00 | C1206C333KARACTU | 12 | $7.08 | $2880.00 | Input Board: C6-C11
Kehmet .015uF SMD Cap | Mouser | 3.2mm | 1.6mm | 1.5mm | $0.34 | $0.17 | $170.00 | C1206C153KARACTU | 6 | $2.04 | $1020.00 | Input Board: C4, C14, C17
Kehmet 47pF SMD Cap | Mouser | 1.6mm | 0.8mm | 0.9mm | $0.07 | $0.01 | $9.00 | C0603C470J5GACTU | 24 | $1.68 | $216.00 | Input Board: C2,C3, C5, C12, C15, C16
Murata Inductor EFI | Mouser | 2mm | 0.85mm | 1.25mm | $0.11 | $0.05 | $53.00 | BLM21BD102SN1D | 12 | $1.32 | $636.00 | Input Board: L7-L12
Maxim RS233a RS232 Driver | Mouser | 9mm | 7.8mm | 7.5mm | $8.70 | $3.47 | $3470.00 | MAX233CPP+G36 | 2 | $17.40 | $6940.00 | IC2
D-Sub 9 Connector | Mouser |  |  |  | $2.32 | $1.50 | $1500.00 | 56F404-001 | 2 | $4.64 | $3000.00 | X3 | **Exponential trendline
Xbee Connector 2mm pitch | Mouser | 11mm | 2.4mm | 7mm | $1.60 | $0.73 | $731.00 | M22-7131042 | 4 | $6.40 | $2924.00 | XB1
16MHz Crystal | Mouser | 11.5mm | 4.8mm | 4.2mm | $0.41 | $0.15 | $154.00 | ABLS-16.000MHZ-B4-T | 2 | $0.82 | $308.00 | U3
32.768kHz Crystal | Mouser | 4.9mm | 1.8mm | 1mm | $0.99 | $0.46 | $460.00 | ABS10-32.768KHZ-7-T | 2 | $1.98 | $920.00 | Y1
Tyco 6P Terminal Block | Mouser |  |  |  | $2.33 | $1.56 | $1560.00 | 796949-6 | 2 | $4.66 | $3120.00
Tyco 3P Terminal Block | Mouser |  |  |  | $0.83 | $0.49 | $495.00 | 796949-3 | 2 | $1.66 | $990.00
Varistor | Mouser |  | 5mm | 5mm | $0.26 | $0.20 | $200.00 | V8ZA05P | 6 | $1.56 | $1200.00 | Input Board: R3-R5
Linear Regulator | Mouser |  |  |  | $1.54 | $0.69 | $688.00 | ZSR300GTA | 3 | $4.62 | $2064.00
100nF SMD Cap | Mouser | 6mm | 5mm | 1.8mm | $0.70 | $0.40 | $400.00 | CB037D0104JBA | 6 | $4.20 | $2400.00 | Main: C1. C24, C18, C23, C20
22uF SMD Cap | Mouser | 5.4mm | 5mm |  | $0.54 | $0.08 | $78.00 | EEE-1CA220SR | 4 | $2.16 | $312.00 | Main: C19,C13
22pF SMD Cap | Mouser | 1mm | 0.5mm | 0.5mm | $0.09 | $0.01 | $11.00 | CGA2B2C0G1H220J | 4 | $0.36 | $44.00 | Main: C26, C27
18pF SMD Cap | Mouser | 1mm | 0.5mm | 0.5mm | $0.09 | $0.01 | $11.00 | CGA2B2C0G1H180J | 4 | $0.36 | $44.00
Red SMD LED | Mouser | 1.2mm | .6mm |  | $0.40 | $0.13 | $132.00 | HSMC-C190 | 2 | $0.80 | $264.00 | LED1, LED2
Green SMD LED | Mouser | 1.2mm | .6mm |  | $0.88 | $0.41 | $410.00 | HSMQ-C120 | 2 | $1.76 | $820.00 | LED3, LED4
Amber SMD LED | Mouser | 1.2mm | .6mm |  | $0.40 | $0.13 | $132.00 | HSMA-C190 | 2 | $0.80 | $264.00 | LED5, LED6
7pF SMD Cap | Mouser | 0.6mm | 0.3mm | 0.3mm | $0.03 | $0.01 | $7.00 | C0603C0G1E070C | 4 | $0.12 | $28.00
Tact Switch | Mouser | 6.6mm | 6mm | 3.65mm | $0.47 | $0.26 | $260.00 | B3W-1052 | 6 | $2.82 | $1560.00 | Main: S1 and S2
Current Transformer | Mouser | 23.5mm | 12mm | 24.8mm | $6.11 | $3.00 | $3000.00 | CST-1020 | 3 | $18.33 | $9000.00 |  | **Exponential trendline
5pF SMD Cap | Mouser | 0.6mm | 0.3mm | 0.3mm | $0.03 | $0.01 | $5.00 | C0603C0G1E050C | 2 | $0.06 | $10.00 | Main: C21, C22
MSP430-Microcontroller | Texas Instruments | 16.2mm | 16.2mm | 1.45mm | $7.90 | $7.00 | $7000.00 | MSP430F47197IPZ | 1 | $7.90 | $7000.00 | U1 | ***Called TI for a price quote on 1000
330 Kohm Resistor | Mouser | 12mm | 5mm | 5mm | $0.18 | $0.04 | $36.00 | 294-330K-RC | 9 | $1.62 | $324.00 | Input Board: R2, R18-R20, R24-R26, R30, R31
1 Kohm Resistor | Mouser | 8.5mm | 3mm | 3mm | $0.19 | $0.02 | $20.00 | CF1/2CT52R102G | 16 | $3.04 | $320.00 | Input Board: R17, R23, R29, R7, R8, R10, R11, R13, R14 Main Board: R33-R38, R39
100 Ohm Resistor | Mouser | 3.2mm | 1.7mm | 1.7mm | $0.08 | $0.02 | $20.00 | CFS1/4CT52R101G | 3 | $0.24 | $60.00 | Input Board: R16, R22, R28
1.5KOhm Resistor | Mouser | 6.8mm | 2.5mm | 2.5mm | $0.11 | $0.01 | $8.00 | 291-1.5K-RC | 3 | $0.33 | $24.00 | Input Board: R15, R21, R27
20 Ohm Resistor | Mouser | 3.2mm | 1.7mm | 1.7mm | $0.08 | $0.02 | $20.00 | CFS1/4CT52R200G | 3 | $0.24 | $60.00 | Input Board: R6, R9, R12
10 Ohm Resistor | Mouser | 8.5mm | 3mm | 3mm | $0.32 | $0.02 | $20.00 | CF1/2CT52R100J | 1 | $0.32 | $20.00 | Main: R32
47KOhm Resistor | Mouser | 6.1mm | 2.3mm | 2.3mm | $0.15 | $0.01 | $6.00 | CF1/4CT52R473J | 3 | $0.45 | $18.00 | Main: R1, R41, R42
10KOhm Resistor | Mouser | 8.5mm | 3mm | 3mm | $0.32 | $0.02 | $20.00 | CF1/2CT52R103J | 1 | $0.32 | $20.00 | Main: R40
BJT | Mouser | 4.45mm | 3.18mm | 17.02mm | $0.10 | $0.04 | $40.00 | 2N3904 | 2 | $0.20 | $80.00 | Main: Q1, Q2
MOSFET | Digikey | 6.5mm | 7mm | 1.6mm | $8.08 | $4.96 | $4960.00 | IRLL3303 | 1 | $8.08 | $4960.00 | Main: Q3
Total for all parts | $164.63
Total for Final Design | For One: | $159.99 | For 1000 | $159990.00

Sheet: Breakers
Breakers
Part | Vendor | Length | Width | Height | Unit Price | Price if ordering 1000 | Total for 1000 | Item Number | Quantity | Total for one Breaker | Total for 1000 | Location on Schematic
Standard Clock Oscillators | Mouser | 20.86mm |  |  | $1.87 | 1.16 | $1160.00 | ECX-100AX-3.579545 | 2 | $3.74 | $2320.00 | NA | **Did not use these in final design
Solid State Relays | Mouser | 58.2mm | 45mm | 29mm | $18.42 | 13 | $13000.00 | STH24D25 | 2 | $36.84 | $26000.00 | To the right of S1 | **Exponential Trendline
5pF SMD Cap | Mouser | 0.6mm | 0.3mm | 0.3mm | $0.03 | 0.005 | $5.00 | C0603C0G1E050C | 2 | $0.06 | $10.00 | C6, C7
Opto Isolator | Mouser | 13.97mm | 5.72mm | 5.72mm | $3.03 | 1.76 | $1760.00 | OPI1264C | 4 | $12.12 | $7040.00 | Just above S1
3.579545MHz Crystal | Mouser | 11.4mm | 4.7mm | 4.2mm | $0.63 | 0.35 | $350.00 | ABLSG-3.579545MHZ-D-2-Y-T | 2 | $1.26 | $700.00 | To the right of C6 & C7
ADE7763 Chip | Analog Devices | 7.2mm | 7.4mm | 2mm | $1.66 | 1.61 | $1610.00 | ADE7763ARSZ | 1 | $1.66 | $1610.00 | To the left of C6 & C7
1uF Cap | Mouser | 7mm | 4mm |  | $0.22 | 0.052 | $52.00 | EEA-GA1H1R0 | 1 | $0.22 | $52.00 | C3
100nF | Mouser | 7mm | 4mm |  | $0.22 | 0.052 | $52.00 | EEA-GA1HR10 | 2 | $0.44 | $104.00 | C4, C5
10uF Cap | Mouser | 7mm | 5mm |  | $0.25 | 0.059 | $59.00 | EEA-GA1V100B | 2 | $0.50 | $118.00 | C1, C2
255 KOhm Resistor | Mouser | 6.8mm | 2.5mm |  | $0.13 | 0.012 | $12.00 | 271-255K-RC | 2 | $0.26 | $24.00 | R2, R3
1 Kohm Resistor | Mouser | 3.5mm | 1.85mm |  | $0.15 | 0.017 | $17.00 | 270-1K-RC | 1 | $0.15 | $17.00 | R4
60 ohm Resistor | Mouser | 8.74mm | 3.68mm |  | $0.43 | 0.241 | $241.00 | CMF6060R000BHEB | 1 | $0.43 | $241.00 | R1
LED | Mouser | 12mm | 3mm |  | $0.04 | 0.04 | $40.00 | SLX-LX3044HD | 1 | $0.04 | $40.00 | LED1
Switch | Mouser | 13mm | 7.9mm | 33.3mm | $3.92 | 2.91 | $2910.00 | M2012SD3G01 | 1 | $3.92 | $2910.00 | S1
Current Transformer | Digikey | 37.5mm | 14mm | 39mm | $14.23 | 9.4 | $9400.00 | CR8350-2500-N | 2 | $28.46 | $18800.00 | To the left of R1
Arduino Uno- ATmega328 | SparkFun | 75.2mm | 53.4mm | 14.7mm | $29.95 | 23.96 | $23960.00 | DEV-09950 | 1 | $29.95 | $23960.00
SSOP to DIP Adapter 20-Pin | SparkFun | 18mm | 25.4mm |  | $3.95 | 3.16 | $3160.00 | BOB-00499 | 2 | $7.90 | $6320.00
Total for Final Design | For one: | $124.21 | For 1000: | $87946.00
Total for purchased parts | $127.95
