calvin-college-team-pica/final-design-report/ProjectCosts.tex

{
\small
\begin{longtable}[c]{|c|c|r|r|r|r|}
\caption{Cost estimate for the project.\label{ProjectCosts.tex}}\\
\hline
\multicolumn{5}{|>{\columncolor[gray]{0.75}}c|}{Full Scale Production} \\
\hline
\endfirsthead
\caption[]{Continued from previous page}\\

\hline
\multicolumn{5}{|>{\columncolor[gray]{0.75}}c|}{Full Scale Production} \\
\hline
\endhead
\multicolumn{5}{r}{{Continued on next page}} \\
\endfoot

\endlastfoot
\multirow{6}{*}{Fixed Costs}    & Prototyping           & \$120,700    &              &           \\\cline{2-5}
               & Automated Equipment   &    &              &                          \\\cline{2-5}
               & Marketing/Advertising & \$120,000    &              &                          \\\cline{2-5}
               & Legal        & \$168,000   &              &                          \\\cline{2-5}
               & Facilities            & \$0         &              &                          \\\cline{2-5}
               & Total                 & \$257,500   &              &                          \\\hline\hline
               
\multirow{7}{*}{Variable Costs}  & System                & Breakers  & Base station & E-meter                  \\\cline{2-5}
               & Number of devices     & 1600000   & 64000        & 830000                   \\\cline{2-5}
               & Single device parts   & 35        & 100          & 200                      \\\cline{2-5}
               & Total device parts    & 56000000  & 6400000      & 166000000               \\\cline{2-5}
               & Labor                 & \$48,000,000  & \$960,000       & \$37,350,000                 \\\cline{2-5}
               & Shipping              & \$8,000,000   & \$768,000       & \$16,600,000                 \\\cline{2-5}
               & Inventory             & \$5,100      & \$31,800        & \$6,500                     \\\cline{2-5}
               & Total (per device)& \$70        & \$127          & \$265        \\\hline\hline
\multirow{3}{*}{Totals}         & Total Per Subsystem & \$112,262,600 & \$8,417,300     & \$220,214,000                \\\cline{2-5}
               & Total per device      & \$70        & \$132          & \$265                      \\\cline{2-5}
               & Full System           & \multicolumn{3}{c|}{\$340,893,900.00}    \\\hline
\end{longtable}
}
