calvin-college-team-pica/final-design-report/tables/06_Cost_Per.tex

\begin{table}[htbp]
\begin{center}
\caption{Cost per unit.}
\begin{tabular}{|c|c|r|}\hline
\multirow{6}{*}{Breaker} & Cost of Parts per    & \$35\\\cline{2-3}
                         & Cost of Assembly per & \$23\\\cline{2-3}
                         & Shipping             & \$3\\\cline{2-3}
                         & Total Cost Per       & \$61\\\cline{2-3}
                         & Number               & 38000\\\cline{2-3}
                         & Storage Cost         & \$0.03\\\hline\hline
\multirow{6}{*}{Base Station} & Cost of Parts Per    & \$100\\\cline{2-3}
                              & Cost of Assembly per & \$15\\\cline{2-3}
                              & Shipping             & \$8\\\cline{2-3}
                              & Total Cost Per       & \$123\\\cline{2-3}
                              & Number               & 13000\\\cline{2-3}
                              & Storage Cost         & \$0.57\\\hline\hline
\multirow{6}{*}{E-Meter} & Cost of Parts Per    & \$200\\\cline{2-3}
                         & Cost of Assembly Per & \$38\\\cline{2-3}
                         & Shipping             & \$15\\\cline{2-3}
                         & Total Cost Per       & \$253\\\cline{2-3}
                         & Number               & 166000\\\cline{2-3}
                         & Storage Cost         & \$0.21\\\hline\hline
\multirow{6}{*}{System} & Cost of Parts Per    & \$216\\\cline{2-3}
                        & Cost of Assembly Per & \$44\\\cline{2-3}
                        & Shipping             & \$16\\\cline{2-3}
                        & Total Cost Per       & \$277\\\cline{2-3}
                        & Number               & 166000\\\cline{2-3}
                        & Storage Cost         & \$0.26\\\hline\hline
\end{tabular}
\label{tab:costs_per}
\end{center}
\end{table}
