calvin-college-team-pica/final-design-report/tables/EMeterCost.tex

{
\small
\begin{longtable}[c]{|c|c|c|c|c|c|c|c|c|c|c|c|}
\caption{default\label{EMeterCost.tex}}\\
\hline
\rowcolor{blue}
 & PICA &  &  &  &  &  &  &  &  &  &  \\
\hline
\endfirsthead
\caption[]{Continued from previous page}\\

\hline
\rowcolor{blue}
 & PICA &  &  &  &  &  &  &  &  &  &  \\
\hline
\endhead
\multicolumn{12}{r}{{Continued on next page}} \\
\endfoot

\endlastfoot
                                                                                                                                & Pro-Forma Statement of Income     &  &              &  &           &  &           &  &           &  &           \\
\hline
                                                                                                                                &                                   &  &              &  &           &  &           &  &           &  &           \\
\hline
                                                                                                                                & Year 1                            &  & Year 2       &  & Year 3    &  &           &  &           &  &           \\
\hline
                                                                                                                                &                                   &  &              &  &           &  &           &  &           &  &           \\
\hline
Sales revenue                                                                                                                   & 190000000                         &  & 238336000    &  & 266936320 &  &           &  &           &  &           \\
\hline
Variable Cost of Goods Sold                                                                                                     & 167245000                         &  & 209792128    &  & 234967183 &  &           &  &           &  &           \\
\hline
Fixed Cost of Goods Sold                                                                                                        & 1867500                           &  & 2342592      &  & 2623703   &  &           &  &           &  &           \\
\hline
Depreciation                                                                                                                    & 2858                              &  & 4898         &  & 3498      &  &           &  &           &  &           \\
\hline
Gross Margin                                                                                                                    & 20884642                          &  & 26196382     &  & 29341936  &  &           &  &           &  &           \\
\hline
Variable Operating Costs                                                                                                        & 16600000                          &  & 20823040     &  & 23321805  &  &           &  &           &  &           \\
\hline
Fixed Operating Costs                                                                                                           & 31470                             &  & 18621        &  & 13103     &  &           &  &           &  &           \\
\hline
Operating Income                                                                                                                & 4253172                           &  & 5354721      &  & 6007028   &  &           &  &           &  &           \\
\hline
Interest Expense                                                                                                                & 30000                             &  & 105000       &  & 204000    &  &           &  &           &  &           \\
\hline
Income Before Tax                                                                                                               & 4223172                           &  & 5249721      &  & 5803028   &  &           &  &           &  &           \\
\hline
Income tax (40\%)                                                                                                                & 1689269                           &  & 2099889      &  & 2321211   &  &           &  &           &  &           \\
\hline
Net Income After Tax                                                                                                            & 2533903                           &  & 3149833      &  & 3481817   &  &           &  &           &  &           \\
\hline
                                                                                                                                &                                   &  &              &  &           &  &           &  &           &  &           \\
\hline
                                                                                                                                &                                   &  &              &  &           &  &           &  &           &  &           \\
\hline
                                                                                                                                & PICA                              &  &              &  &           &  &           &  &           &  &           \\
\hline
                                                                                                                                & Pro-Forma Statement of Cash Flows &  &              &  &           &  &           &  &           &  &           \\
\hline
                                                                                                                                &                                   &  &              &  &           &  &           &  &           &  &           \\
\hline
                                                                                                                                & Year 1                            &  & Year 2       &  & Year 3    &  &           &  &           &  &           \\
\hline
                                                                                                                                &                                   &  &              &  &           &  &           &  &           &  &           \\
\hline
Beginning Cash Balance                                                                                                          & 0                                 &  & 4016761      &  & 9421492   &  &           &  &           &  &           \\
\hline
Net Income After Tax                                                                                                            & 2533903                           &  & 3149833      &  & 3481817   &  &           &  &           &  &           \\
\hline
Depreciation expense                                                                                                            & 2858                              &  & 4898         &  & 3498      &  &           &  &           &  &           \\
\hline
Invested Capital (Equity)                                                                                                       & 1000000                           &  & 1500000      &  & 2000000   &  &           &  &           &  &           \\
\hline
Increase (decrease) in borrowed funds                                                                                           & 500000                            &  & 750000       &  & 900000    &  &           &  &           &  &           \\
\hline
Equipment Purchases                                                                                                             & -20000                            &  & 0            &  & 0         &  &           &  &           &  &           \\
\hline
Ending Cash Balance                                                                                                             & 4016761                           &  & 9421492      &  & 15806807  &  &           &  &           &  &           \\
\hline
                                                                                                                                &                                   &  &              &  &           &  &           &  &           &  &           \\
\hline
\multicolumn{12}{r}{* Assume no change in Accounts Receivable, Inventory or other current assets other than cash; Accounts Payable or other current liabilities other than Notes Payable; Fixed Assets other than equipment; or Equity Accounts other than Retained Earnings } \\
                                                                                                                                &                                   &  &              &  &           &  &           &  &           &  &           \\
\hline
                                                                                                                                & PICA                              &  &              &  &           &  &           &  &           &  &           \\
\hline
                                                                                                                                & Break - Even Analysis             &  &              &  &           &  &           &  &           &  &           \\
\hline
                                                                                                                                &                                   &  &              &  &           &  &           &  &           &  &           \\
\hline
                                                                                                                                & Year 1                            &  &              &  & Year 2    &  &           &  & Year 3    &  &           \\
\hline
                                                                                                                                &                                   &  &              &  &           &  &           &  &           &  &           \\
\hline
Sales revenue                                                                                                                   &                                   &  & 190000000    &  &           &  & 238336000 &  &           &  & 266936320 \\
\hline
Less: Variable Costs:                                                                                                           &                                   &  &              &  &           &  &           &  &           &  &           \\
\hline
Variable Cost of Goods Sold                                                                                                     & 167245000                         &  &              &  & 209792128 &  &           &  & 234967183 &  &           \\
\hline
Variable Operating Costs                                                                                                        & 16600000                          &  &              &  & 20823040  &  &           &  & 23321805  &  &           \\
\hline
Total Variable Costs                                                                                                            &                                   &  & 183845000    &  &           &  & 230615168 &  &           &  & 258288988 \\
\hline
Contribution Margin                                                                                                             &                                   &  & 6155000      &  &           &  & 7720832   &  &           &  & 8647332   \\
\hline
Less: Fixed Costs                                                                                                               &                                   &  &              &  &           &  &           &  &           &  &           \\
\hline
Fixed Cost of Goods Sold                                                                                                        & 1867500                           &  &              &  & 2342592   &  &           &  & 2623703   &  &           \\
\hline
Fixed Operating Costs                                                                                                           & 31470                             &  &              &  & 18621     &  &           &  & 13103     &  &           \\
\hline
Depreciation                                                                                                                    & 2858                              &  &              &  & 4898      &  &           &  & 3498      &  &           \\
\hline
Interest Expense                                                                                                                & 30000                             &  &              &  & 105000    &  &           &  & 204000    &  &           \\
\hline
Total Fixed Costs                                                                                                               &                                   &  & 1931828      &  &           &  & 2471111   &  &           &  & 2844304   \\
\hline
Income Before Tax                                                                                                               &                                   &  & 4223172      &  &           &  & 5249721   &  &           &  & 5803028   \\
\hline
                                                                                                                                &                                   &  &              &  &           &  &           &  &           &  &           \\
\hline
                                                                                                                                &                                   &  &              &  &           &  &           &  &           &  &           \\
\hline
                                                                                                                                & Year 1                            &  & Year 2       &  & Year 3    &  &           &  &           &  &           \\
\hline
                                                                                                                                &                                   &  &              &  &           &  &           &  &           &  &           \\
\hline
Total Fixed Costs                                                                                                               & 1931828                           &  & 2471111      &  & 2844304   &  &           &  &           &  &           \\
\hline
Contribution Margin \%                                                                                                           & 3\%                                &  & 3\%           &  & 3\%        &  &           &  &           &  &           \\
\hline
                                                                                                                                &                                   &  &              &  &           &  &           &  &           &  &           \\
\hline
Break Even Sales Volume                                                                                                         & 59634008                          &  & 76281241     &  & 87801409  &  &           &  &           &  &           \\
\hline
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
\hline
                                                                                                                                & Year 1                            &  & Year 2       &  & Year 3    &  &           &  &           &  &           \\
\hline
Average debt balance                                                                                                            & 250000                            &  & 875000       &  & 1700000   &  &           &  &           &  &           \\
\hline
Interest expense                                                                                                                & 30000                             &  & 105000       &  & 204000    &  &           &  &           &  &           \\
\hline
\hline
\end{longtable}
}
