calvin-college-team-pica/final-design-report/Figures/NJSwitchComponentOptions.jpg

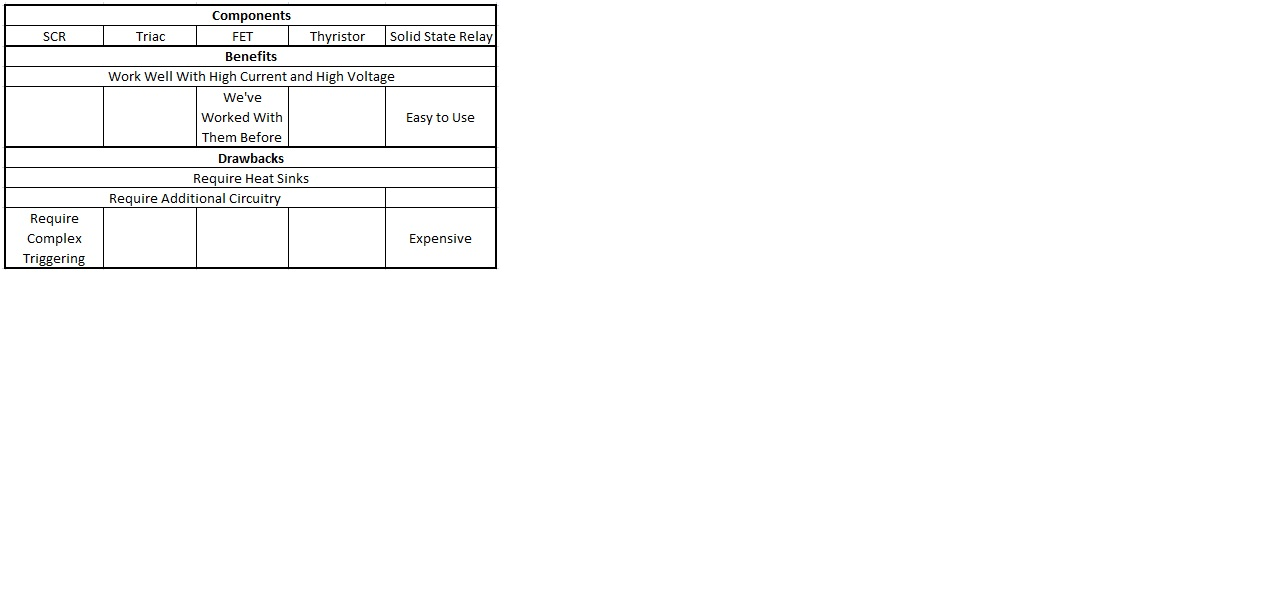
Figures/NJSwitchComponentOptions.jpg
