calvin-college-team-pica/final-design-report/includes/PICA_System_Diagram_B.pdf

## Power Lines

## Power Supplies

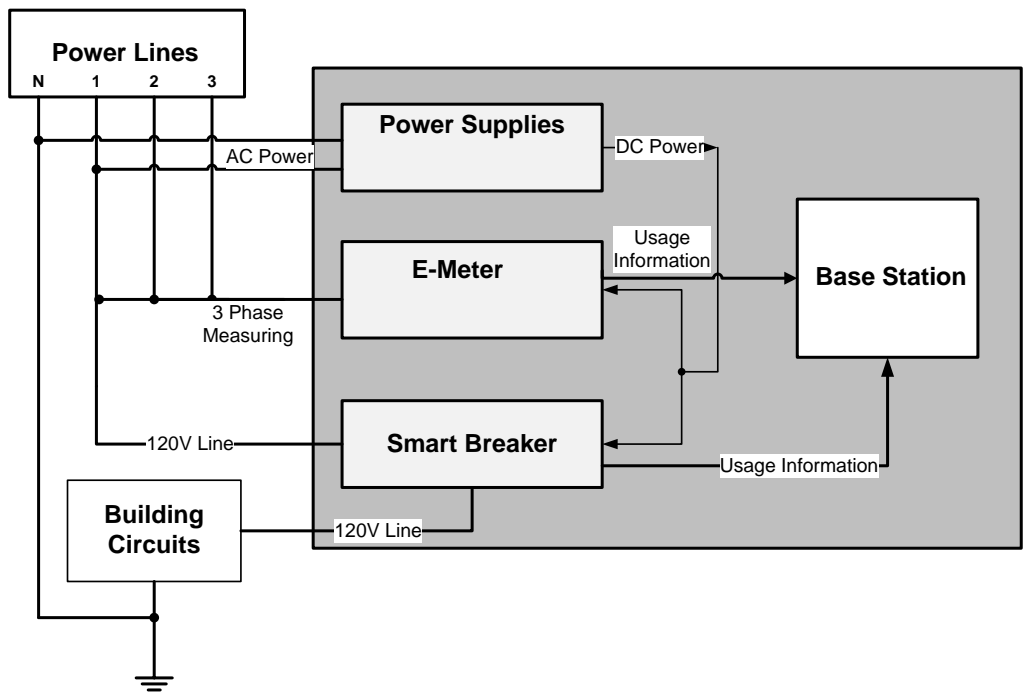
[picture p78: page 1]
E-Meter; Smart Breaker; 120V Line; Building Circuits; Base Station; Usage Information; AC Power; DC Power; 3 Phase Measuring
