calvin-college-team-pica/final-design-report/includes/System_Diagram_B.pdf

## E-Meter

MSP430 | LCD Display

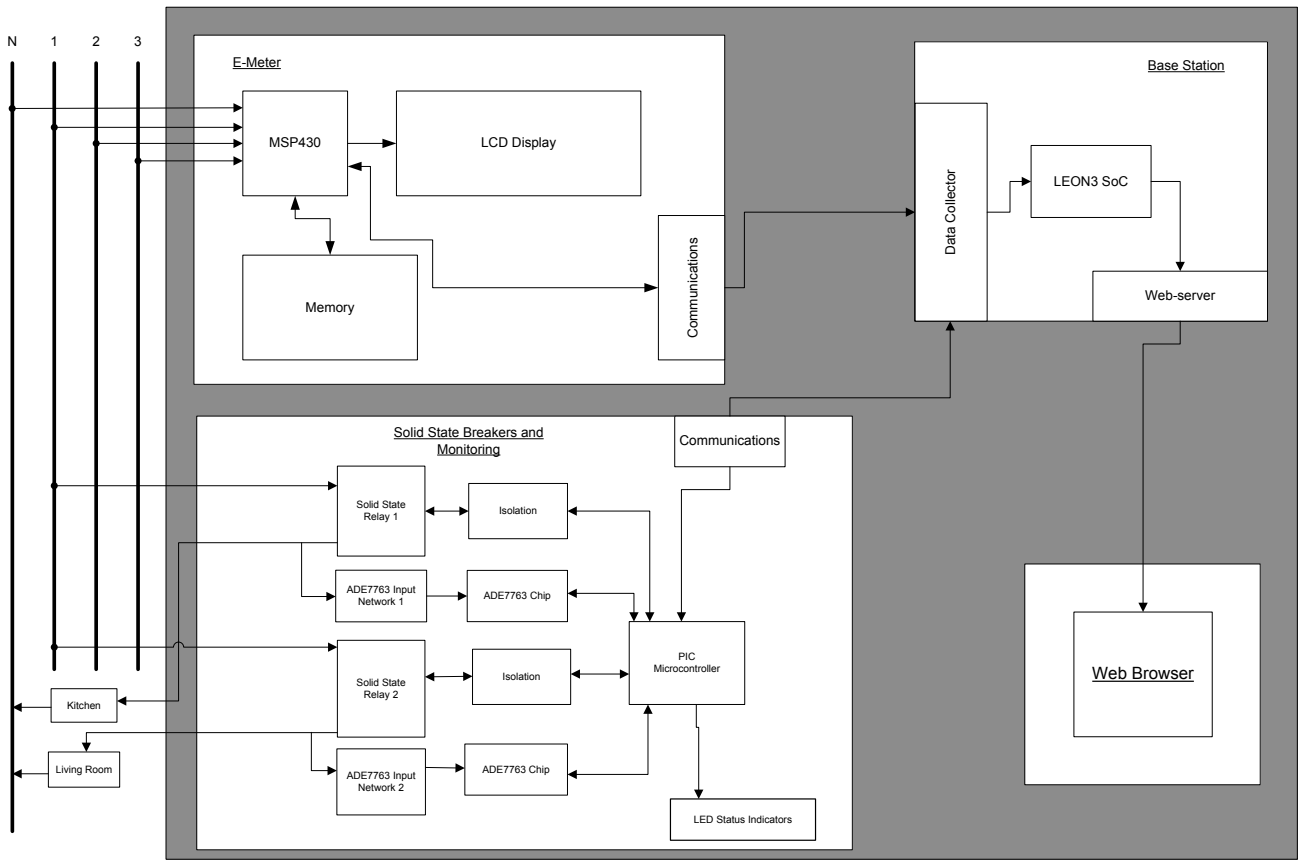
[picture p79: page 1]
Memory; Com; munications; Base Station; Web-server; Solid State Relay 1; Solid State Relay 2; Isolation; ADE7763 Input Network 1; ADE7763 Input Network 2; ADE7763 Chip; PIC Microcontroller; Kitchen; Living Room; Communications; Web Browser; Data Collector; LEON3 SoC

Solid State Breakers and
Monitoring

LED Status Indicators
