calvin-college-team-pica/final-design-report/includes/E_Meter_Main_Schematic.pdf

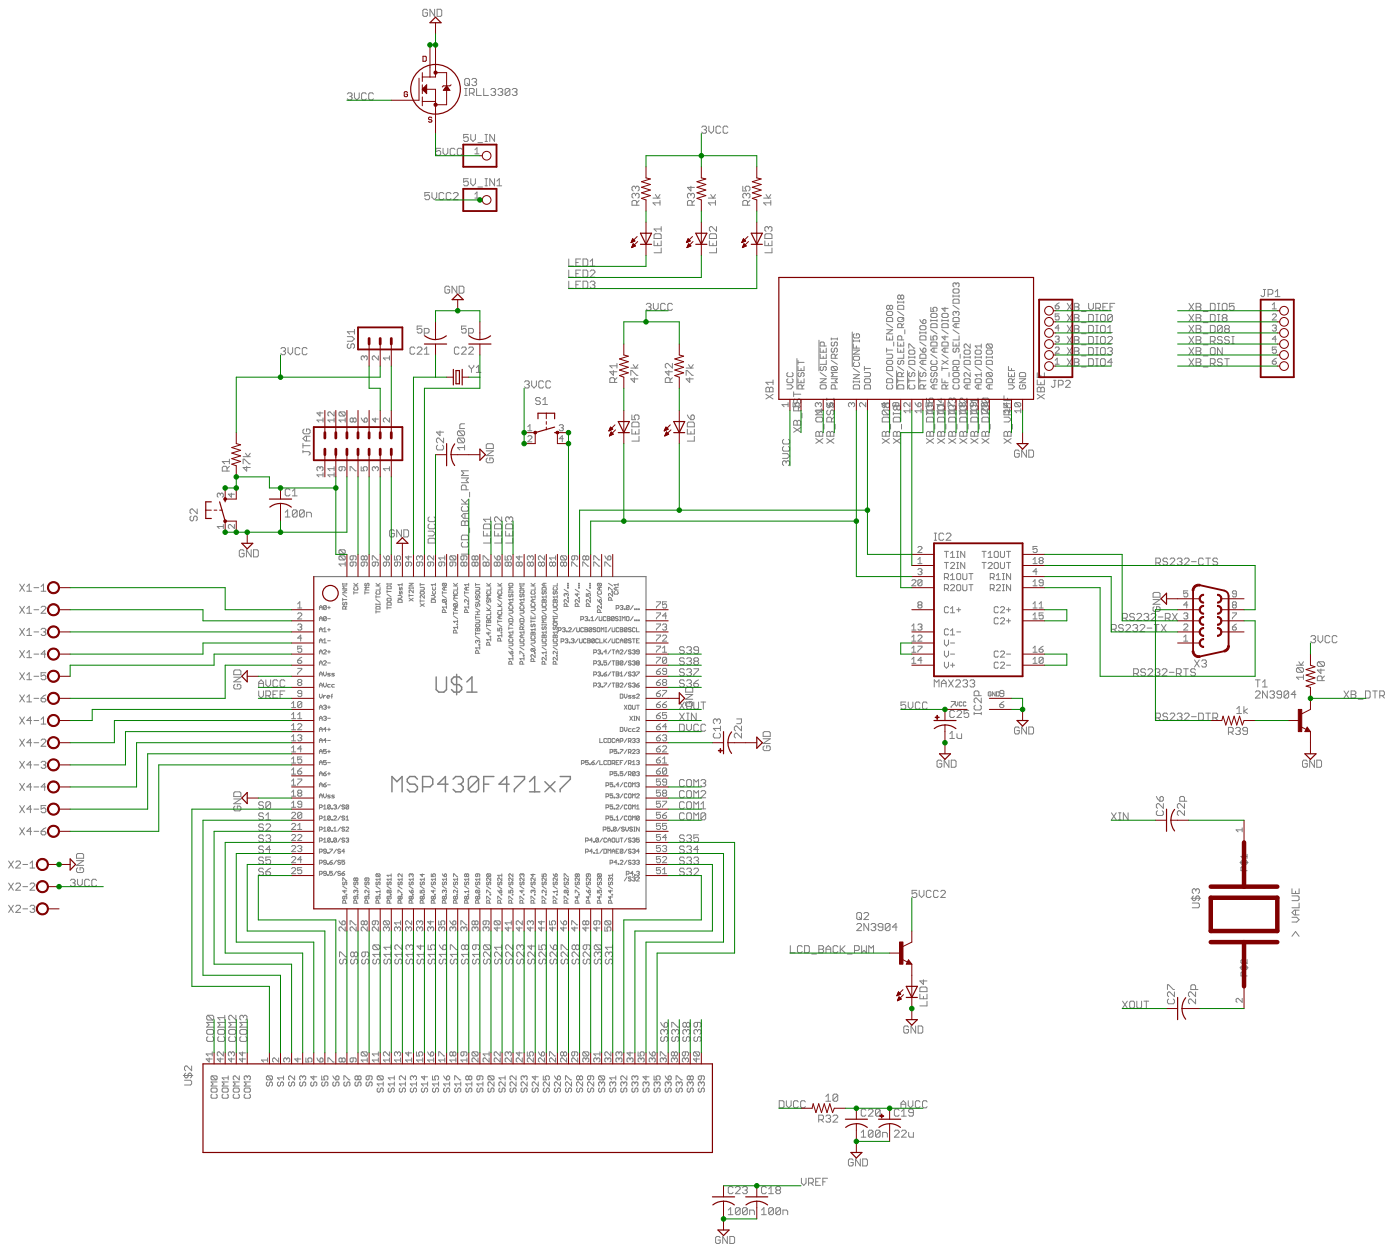
[picture p80: page 1]
