calvin-college-team-pica/final-design-report/Figures/DecadeForecast.pdf

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

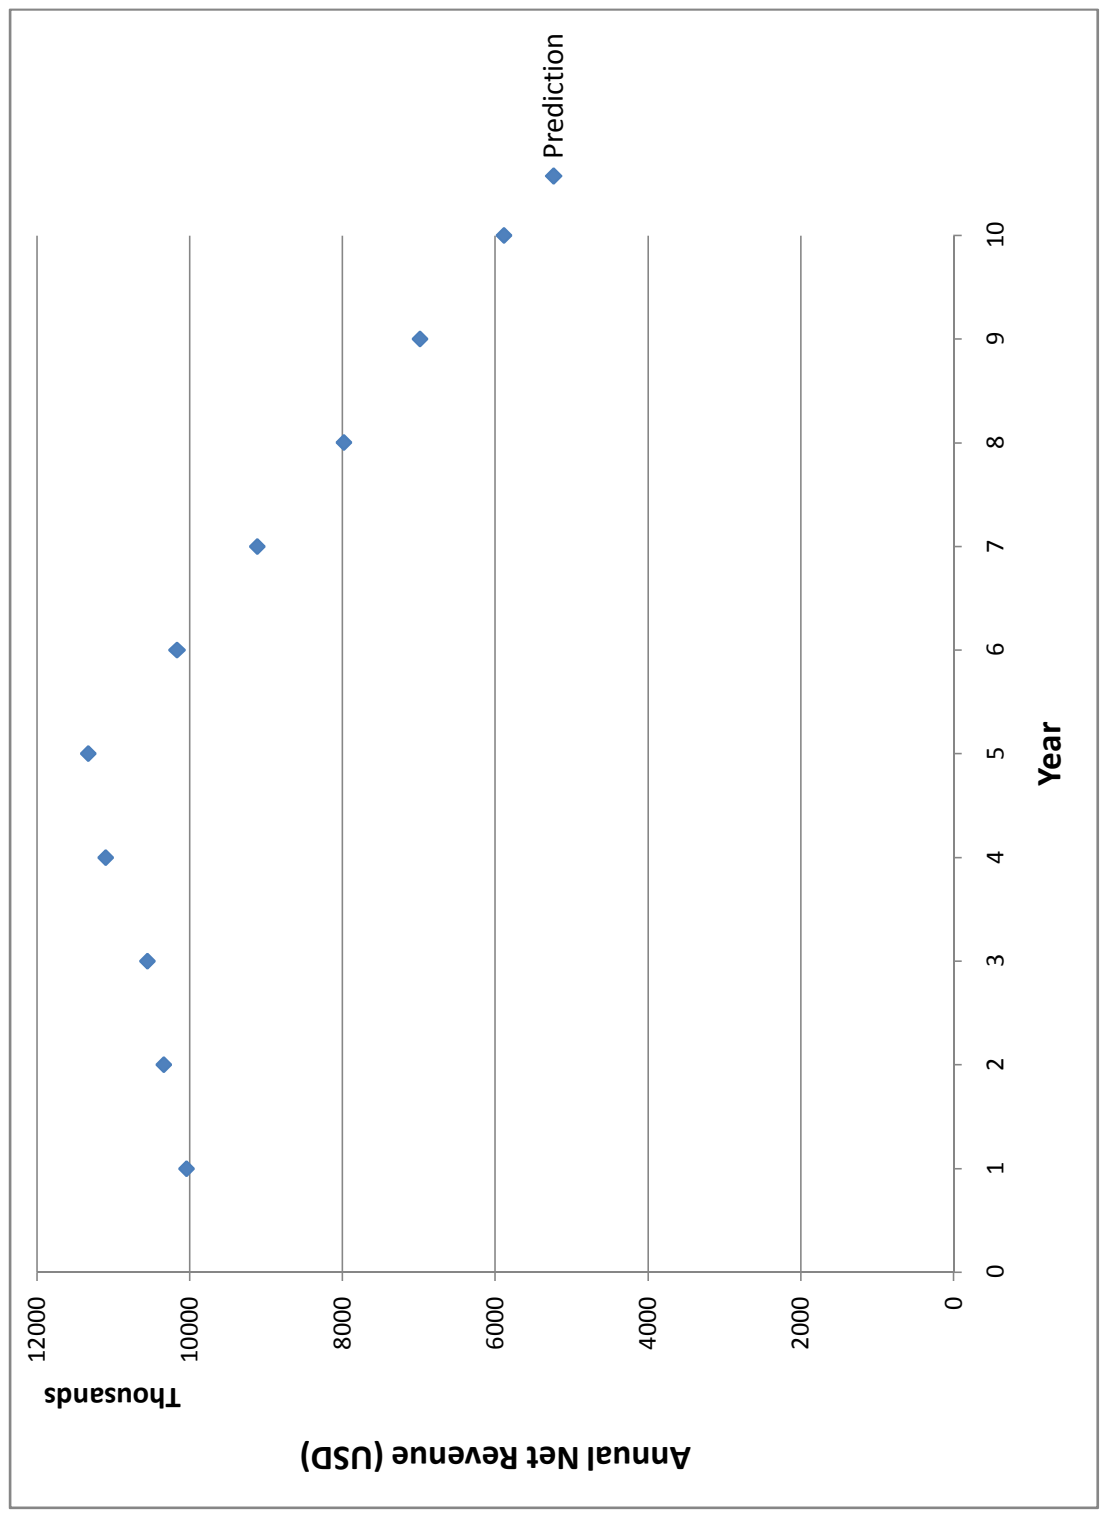
[picture p81: page 1]
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
