calvin-college-team-pica/final-design-report/includes/clock_circuit.pdf

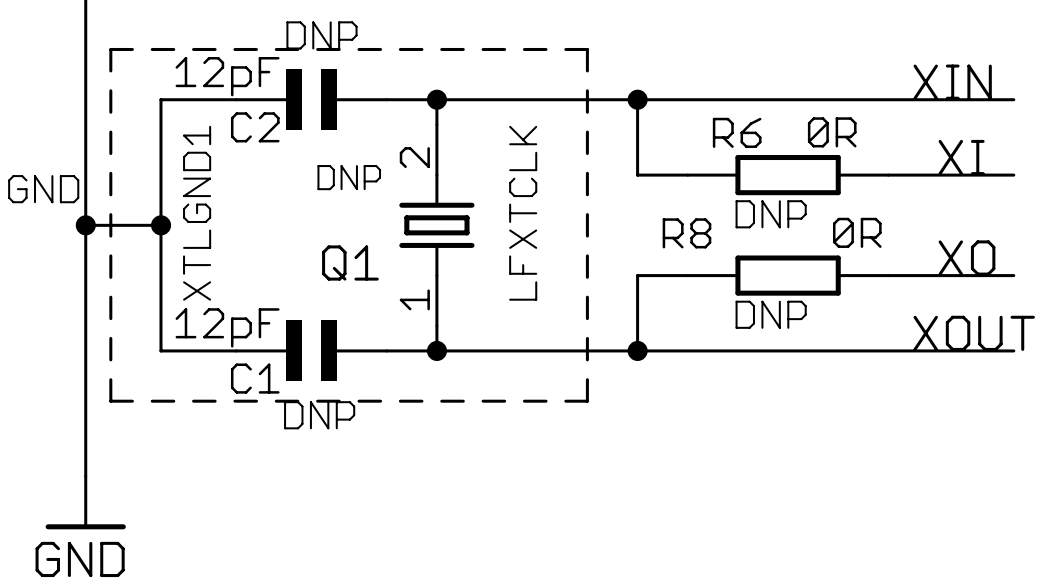
[picture p82: page 1]
