calvin-college-team-pica/final-design-report/includes/e_meter_input_board_large.pdf

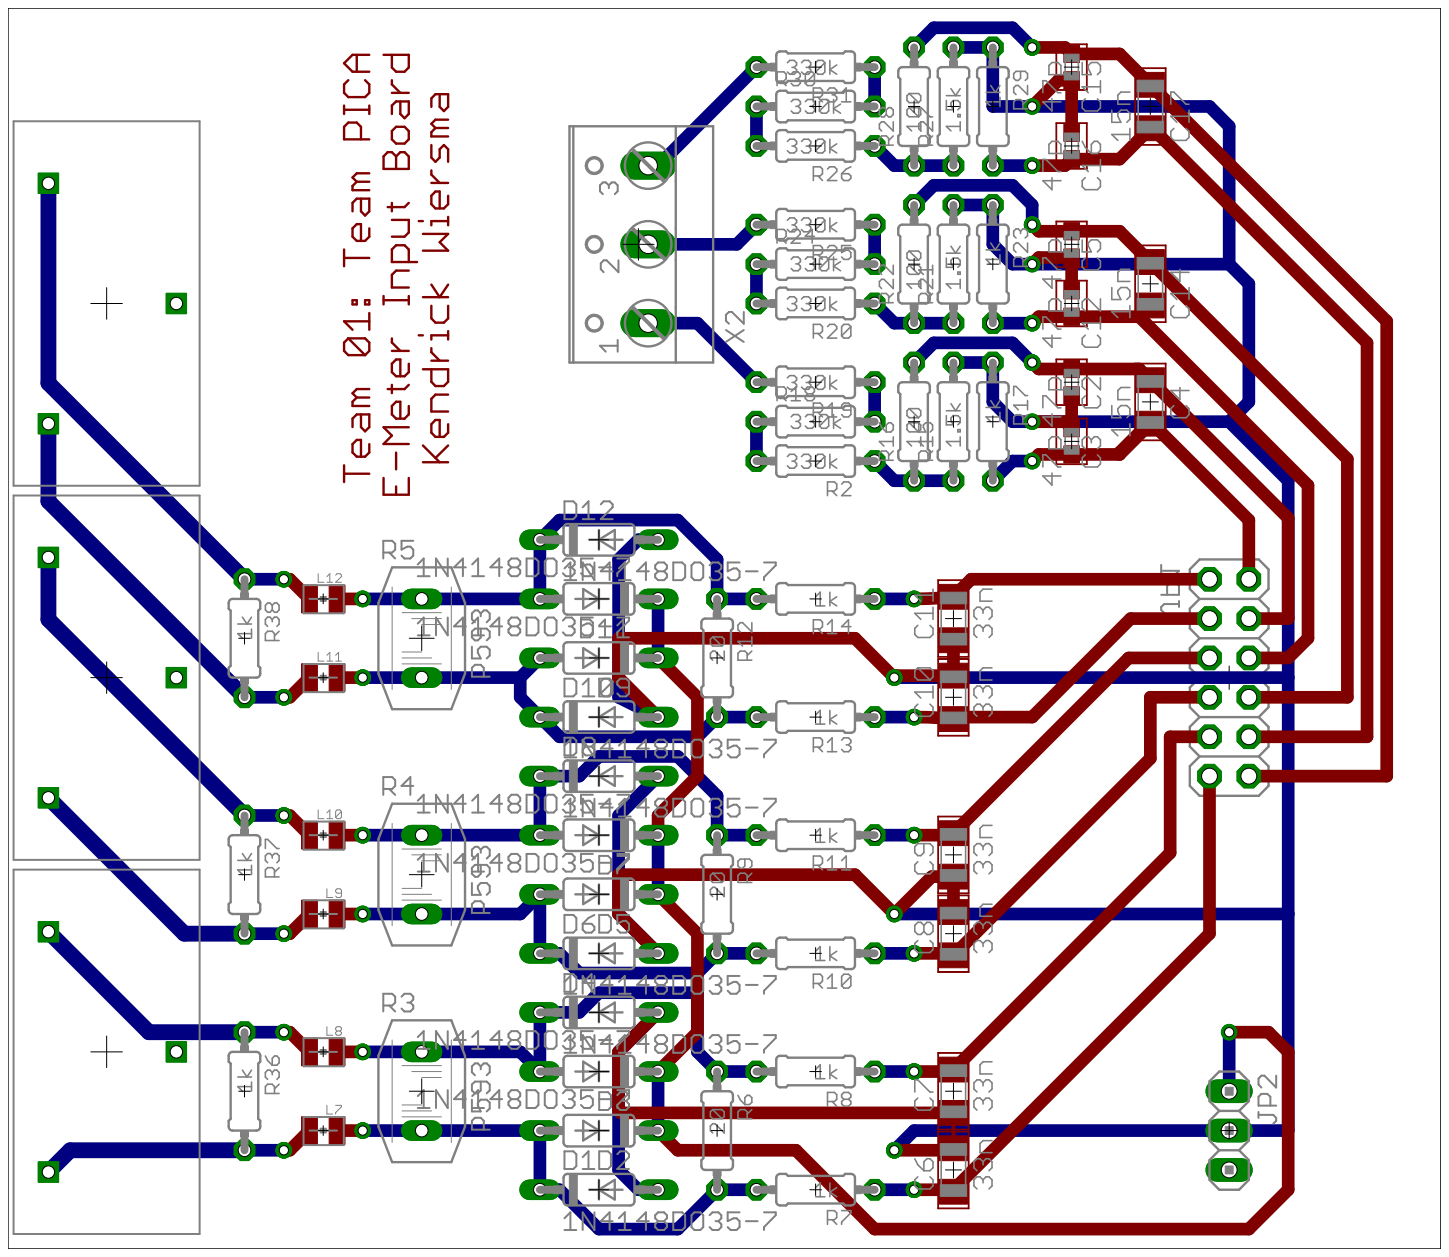
[picture p83: page 1]
