calvin-college-team-pica/final-design-report/includes/e_meter_input_board_schem_large.pdf

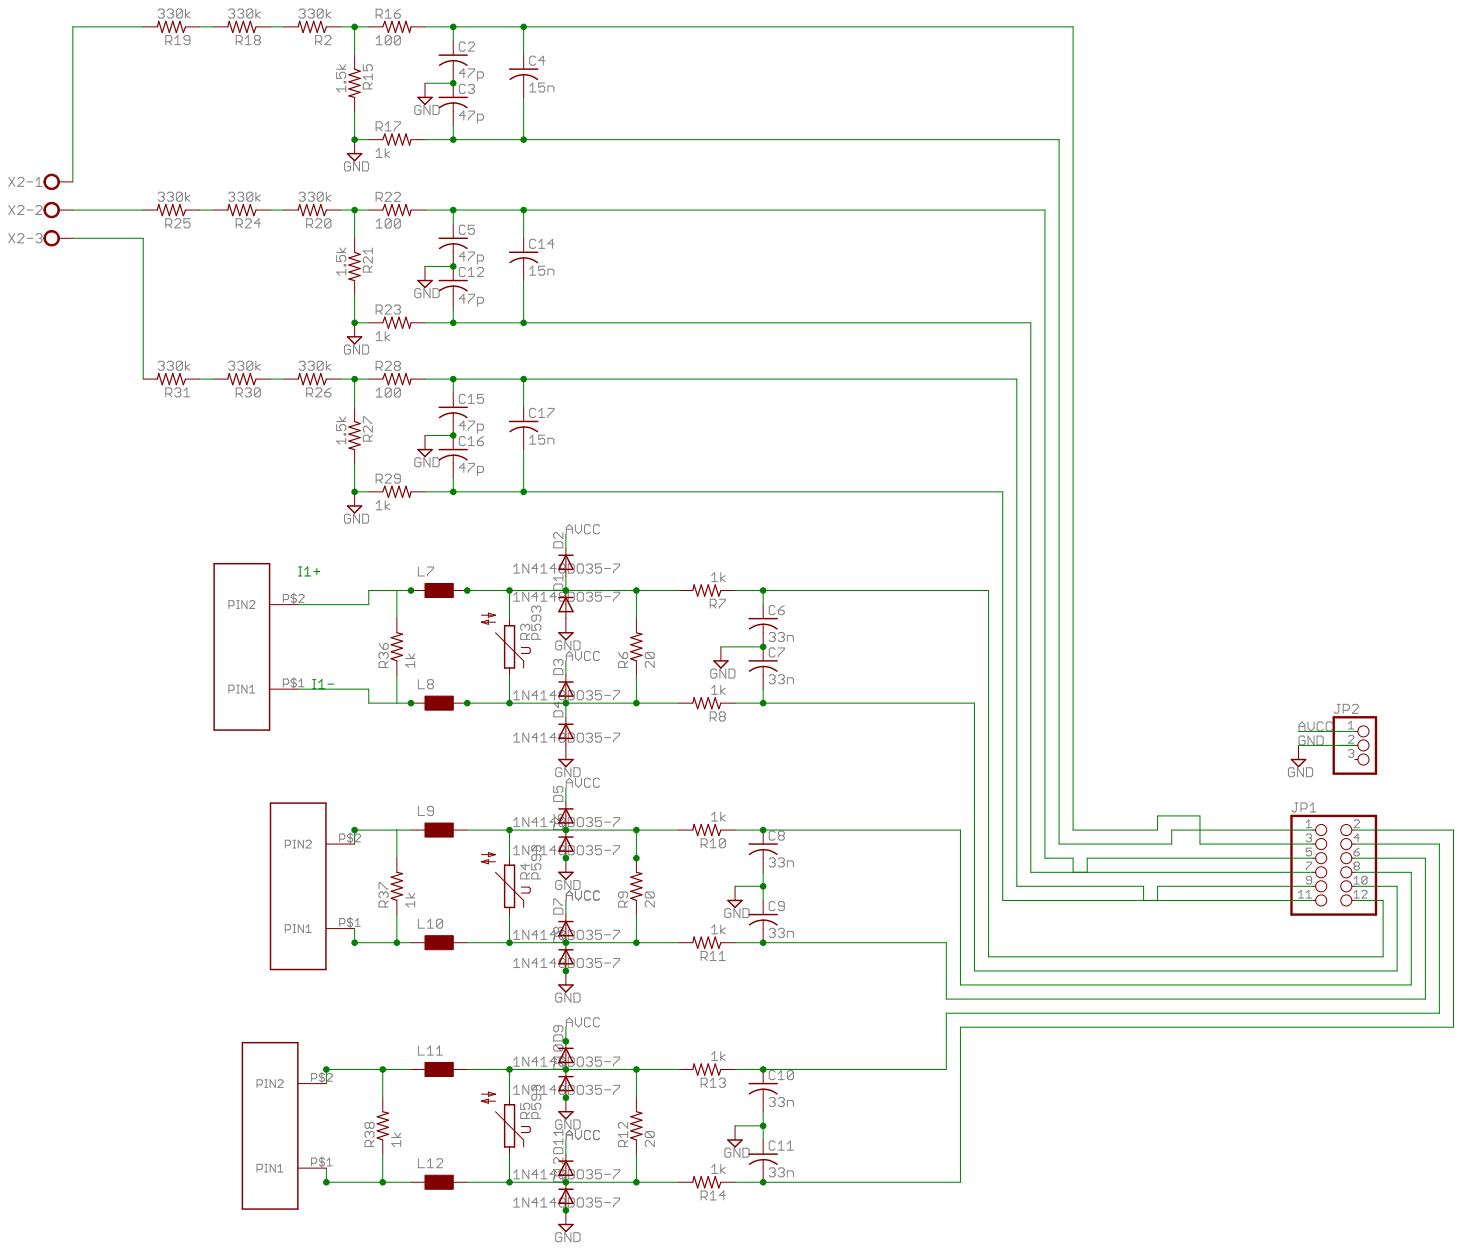
[picture p84: page 1]
