calvin-college-team-pica/final-design-report/includes/e_meter_main_large.pdf

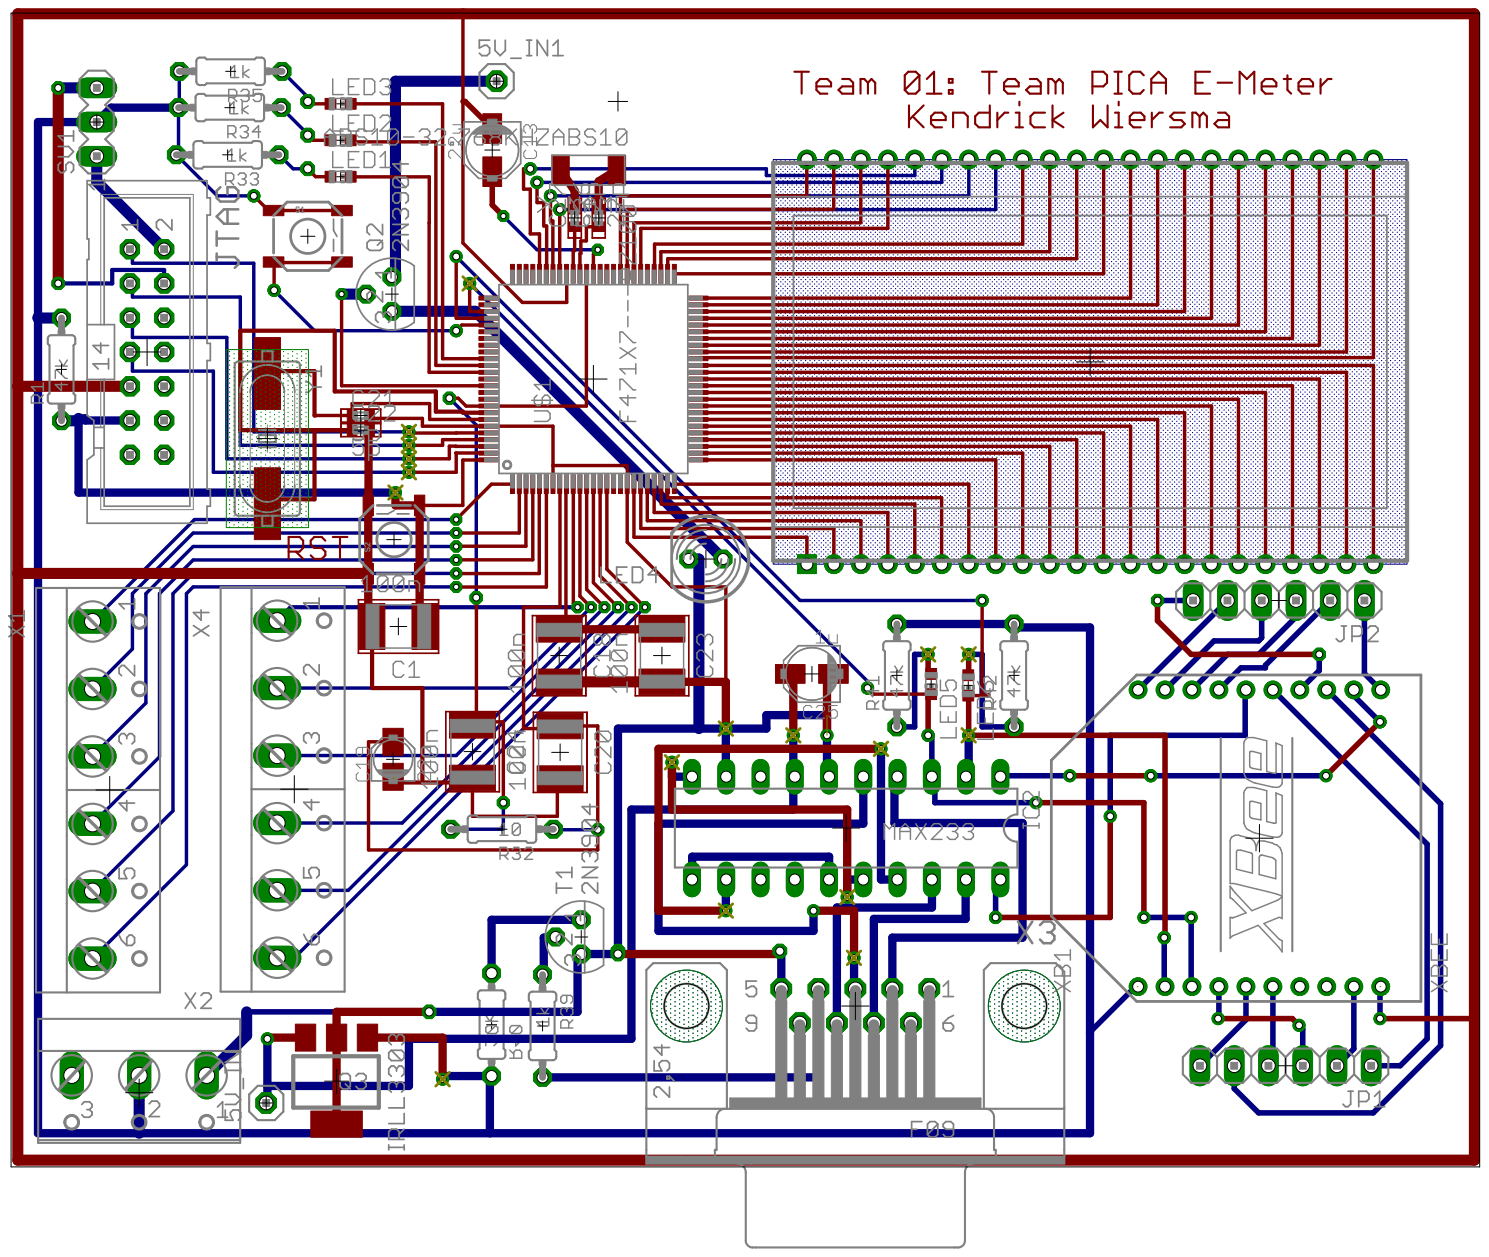
[picture p85: page 1]
