calvin-college-team-pica/final-design-report/includes/TeamPicaLogo.pdf

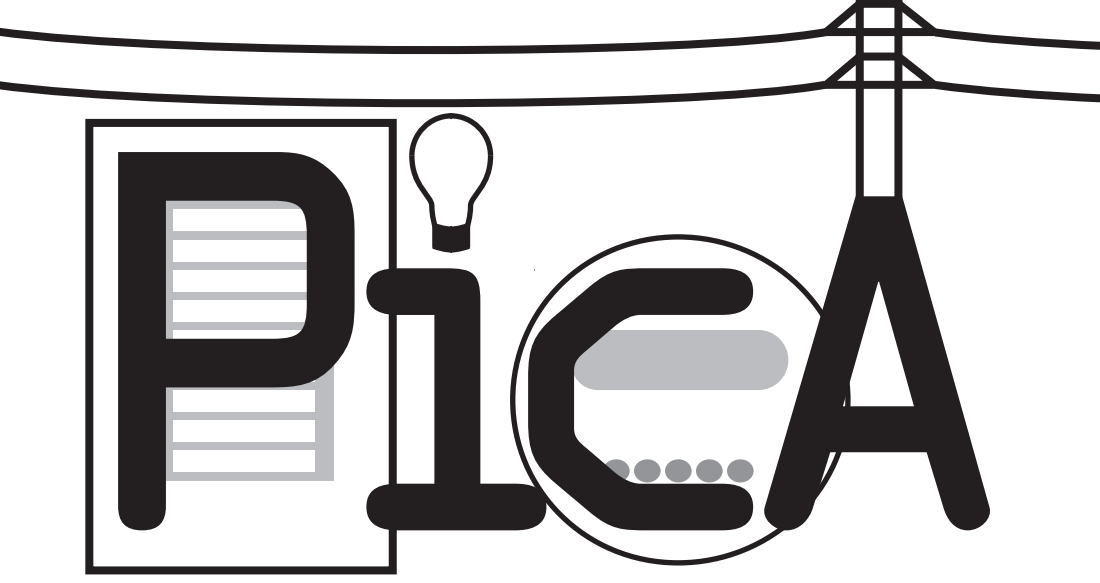
[picture p86: page 1]
